EVR-Tuiasi/Shield_VCU_Board/Shield_VCU_Board/8.3D/PCB_proto_V1.0DWG.jpeg

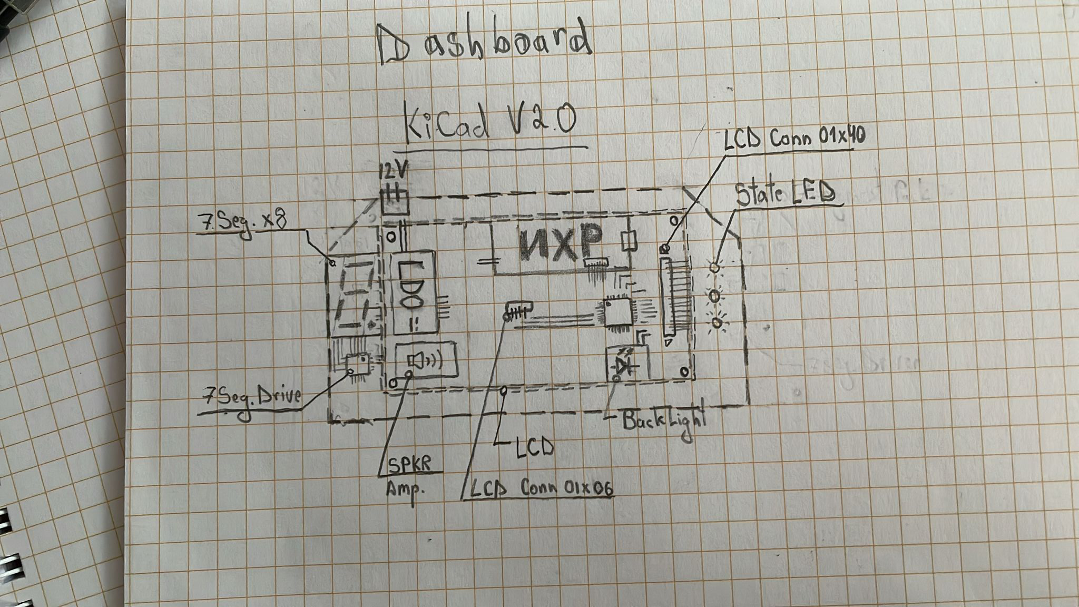
Shield_VCU_Board/8.3D/PCB_proto_V1.0DWG.jpeg
