EVR-Tuiasi/Shield_VCU_Board/Shield_VCU_Board/3.Simulations/8x7SEG_FULL_ON_simulation.jpg

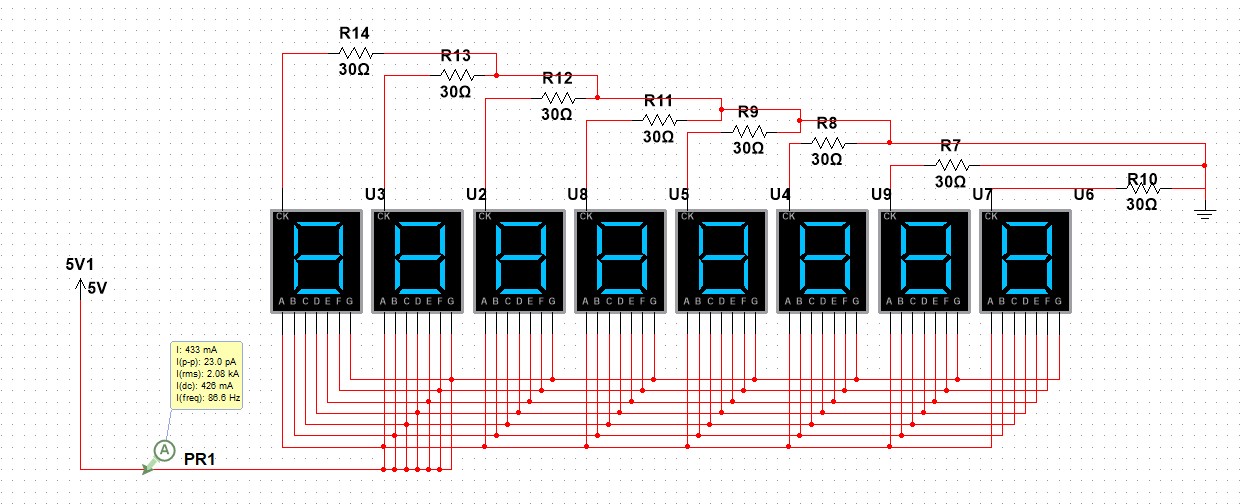
Shield_VCU_Board/3.Simulations/8x7SEG_FULL_ON_simulation.jpg
