EVR-Tuiasi/Shield_VCU_Board/Shield_VCU_Board/3.Simulations/Power_ON3V3_simulation.jpg

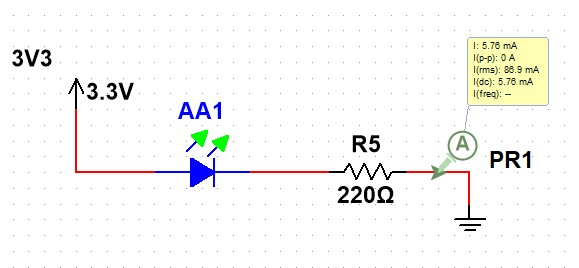
Shield_VCU_Board/3.Simulations/Power_ON3V3_simulation.jpg
