EVR-Tuiasi/Shield_VCU_Board/Shield_VCU_Board/3.Simulations/State_LED_12V_simulation.jpg

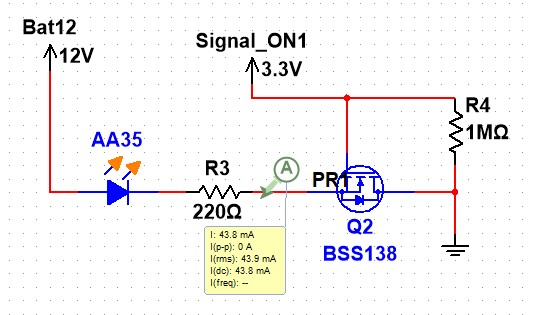
Shield_VCU_Board/3.Simulations/State_LED_12V_simulation.jpg
