EVR-Tuiasi/Shield_VCU_Board/Shield_VCU_Board/4.SupplyArchitecture/BoardSupply.png

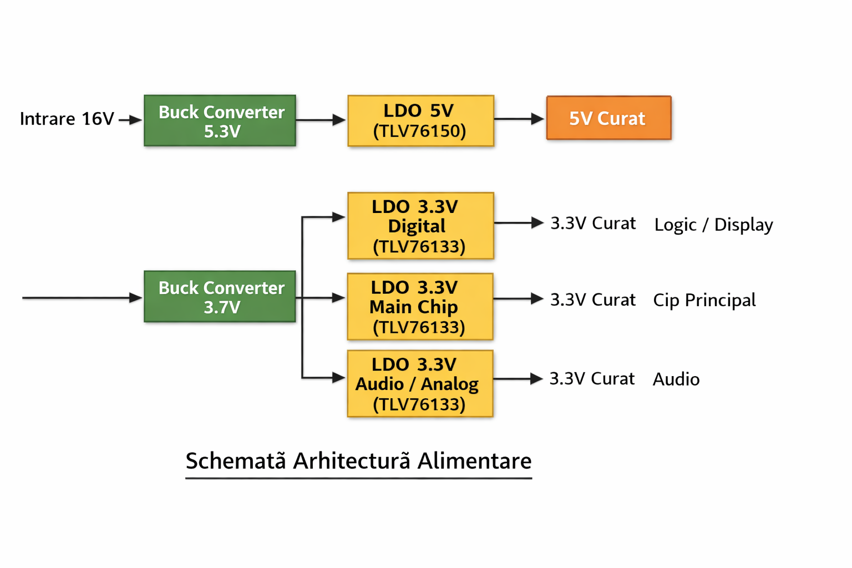
Shield_VCU_Board/4.SupplyArchitecture/BoardSupply.png
