EVR-Tuiasi/Shield_VCU_Board/Shield_VCU_Board/2.DataSheets/S32K344MINI-EVB_HWPackage/Rev. B1/S32K344MINI_RevB1_BOM.xlsx

S32K344MINI-EVB Revised: Wednesday, November 05, 2025
SCH-94921 PDF: SPF-94921 Revision: B1
NXP Semiconductors
6501 William Cannon Drive West
Austin, TX 78735-8598
Bill Of Materials November 19,2025 16:47:33 | Page1
Item | Quantity | AgilePN | ASSY_OPT | Reference | Value | Description | ASSY_NOTE | Mfg Name | Mfg Part Number | PCB Footprint
______________________________________________
1 | 7 | 150-80276 | DNP | C1,C9,C63,C134,C135,C137, | 0.22UF | CAP CER 0.22uF 35V 10% X7R AEC-Q200 0402 |  | TDK | CGA2B1X7R1V224K050BC | CC0402_25
 |  |  |  | C138
2 | 6 | 150-79004 |  | C2,C4,C5,C7,C22,C106 | 10uF | CAP CER 10uF 25V 10% X7R AEC-Q200 1210 |  | MURATA | GCM32ER71E106KA57 | CC1210
3 | 61 | 150-80276 |  | C3,C8,C11,C13,C16,C18, | 0.22UF | CAP CER 0.22uF 35V 10% X7R AEC-Q200 0402 |  | TDK | CGA2B1X7R1V224K050BC | CC0402_25
 |  |  |  | C21,C26,C27,C28,C34,C36,
 |  |  |  | C38,C39,C40,C42,C44,C45,
 |  |  |  | C46,C47,C48,C55,C56,C57,
 |  |  |  | C81,C82,C83,C84,C85,C86,
 |  |  |  | C89,C90,C91,C92,C96,C97,
 |  |  |  | C98,C100,C101,C103,C107,
 |  |  |  | C109,C111,C115,C132,C141,
 |  |  |  | C142,C143,C144,C145,C146,
 |  |  |  | C147,C149,C150,C151,C152,
 |  |  |  | C153,C154,C155,C157,C158
4 | 1 | 150-81432 |  | C6 | 47uF | CAP ALEL 47uF 50V 20% -- SMT |  | Wurth Electronics Inc. | 865080645012 | cce6p8x6p8x8mm
5 | 11 | 150-79081 |  | C10,C12,C14,C20,C29,C32, | 1UF | CAP CER 1uF 25V 10% X7R AEC-Q200 0603 |  | TDK | CGA3E1X7R1E105K080AC | CC0603_OV
 |  |  |  | C41,C102,C108,C140,C159
6 | 4 | 150-10268 |  | C15,C17,C24,C25 | 22uF | CAP CER 22uF 16V 20% X7S AEC-Q200 1206 |  | MURATA | GCM31CC71C226ME36K | cc1206_tol0p3
7 | 2 | 150-79727 |  | C19,C23 | 0.047uF | CAP CER 0.047uF 16V 10% X7R AEC-Q200 0402 |  | MURATA | GCM155R71C473KA37D | CC0402_25
8 | 6 | 150-80122 |  | C30,C31,C37,C49,C75,C79 | 2.2uF | CAP CER 2.2uF 16V 10% X7R 0603 |  | MURATA | GRM188Z71C225KE43 | CC0603_OV
9 | 9 | 150-80120 |  | C33,C35,C43,C54,C87,C88, | 10uF | CAP CER 10uF 10V 20% X7R 0603 |  | MURATA | GRM188Z71A106MA73 | CC0603
 |  |  |  | C95,C110,C131
10 | 16 | 150-79461 |  | C50,C51,C52,C53,C58,C59, | 0.1uF | CAP CER 0.1uF 50V 10% X7R AEC-Q200 0402 |  | MURATA | GCM155R71H104KE02D | CC0402_25
 |  |  |  | C60,C61,C70,C71,C77,C78,
 |  |  |  | C80,C121,C156,C163
11 | 1 | 150-79081 | DNP | C62 | 1UF | CAP CER 1uF 25V 10% X7R AEC-Q200 0603 |  | TDK | CGA3E1X7R1E105K080AC | CC0603_OV
12 | 1 | 150-80122 | DNP | C64 | 2.2uF | CAP CER 2.2uF 16V 10% X7R 0603 |  | MURATA | GRM188Z71C225KE43 | CC0603_OV
13 | 4 | 150-79023 |  | C65,C66,C93,C94 | 10pF | CAP CER 10pF 50V 5% C0G AEC-Q200 0402 |  | MURATA | GCM1555C1H100JA16 | CC0402_25
14 | 2 | 150-76570 |  | C67,C68 | 4.7uF | CAP CER 4.7UF 50V 10% X7R 1210 |  | YAGEO AMERICA | CC1210KKX7R9BB475 | CC1210
15 | 1 | 150-81038 |  | C69 | 47uF | CAP CER 47uF 16V 10% X6S 1210 |  | MURATA | GRM32EC81C476KE15L | CC1210
16 | 1 | 150-30114 |  | C72 | 0.01UF | CAP CER 0.01UF 50V 10% X7R 0402 |  | MURATA | GRM155R71H103KA88D | CC0402_25
17 | 2 | 150-79040 |  | C73,C148 | 1000pF | CAP CER 1000pF 50V 10% X7R AEC-Q200 0402 |  | MURATA | GCM155R71H102KA37D | CC0402_25
18 | 2 | 150-80123 |  | C74,C76 | 4.7uF | CAP CER 4.7uF 16V 10% X7R 0603 |  | MURATA | GRM188Z71C475KE21 | CC0603_OV
19 | 1 | 150-79461 | DNP | C99 | 0.1uF | CAP CER 0.1uF 50V 10% X7R AEC-Q200 0402 |  | MURATA | GCM155R71H104KE02D | CC0402_25
20 | 4 | 150-79021 | DNP | C104,C105,C113,C114 | 100pF | CAP CER 100pF 50V 5% C0G AEC-Q200 0402 |  | MURATA | GCM1555C1H101JA16D | CC0402_25
21 | 1 | 150-30045 |  | C112 | 4700 PF | CAP CER 4700PF 50V 5% X7R 0603 |  | AVX | 06035C472JAT2A | CC0603_OV
22 | 2 | 150-79103 |  | C116,C128 | 1000pF | CAP CER 1000pF 2KV 10% X7R 1206 |  | WALSIN TECHNOLOGY CORP. | 1206B102K202CT | CC1206_OV
23 | 4 | 150-81667 | DNP | C117,C118,C119,C120 | 15pF | CAP CER 15pF 50V 5% C0G 0402 |  | Murata Electronics | GJM1555C1H150JB01D | CC0402_25
24 | 4 | 150-10038 |  | C122,C124,C126,C160 | 0.1uF | CAP CER 0.1uF 100V X7R 10% AEC-Q200 0603 |  | KYOCERA | KAM15BR72A104KT | CC0603_OV
25 | 1 | 150-79364 |  | C123 | 2.2uF | CAP CER 2.2uF 16V 10% X7R AEC-Q200 0805 |  | TDK | CGA4J3X7R1C225K125AB | CC0805_OV
26 | 2 | 150-79530 |  | C125,C127 | 22uF | CAP CER 22uF 10V 20% X5R 0603 |  | SAMSUNG | CL10A226MP7LUNC | CC0603_OV
27 | 2 | 150-79024 |  | C129,C130 | 22pF | CAP CER 22pF 50V 5% C0G AEC-Q200 0402 |  | FENGHUA | AM02CG220J500NT | CC0402_25
28 | 1 | 150-80120 | DNP | C133 | 10uF | CAP CER 10uF 10V 20% X7R 0603 |  | MURATA | GRM188Z71A106MA73 | CC0603
29 | 1 | 150-79004 | DNP | C136 | 10uF | CAP CER 10uF 25V 10% X7R AEC-Q200 1210 |  | MURATA | GCM32ER71E106KA57 | CC1210
30 | 2 | 150-80098 |  | C161,C162 | 100uF | CAP ALEL 100uF 50V 20% -- AEC-Q200 SMT |  | PANASONIC | EEE-FTH101XAP | cce6p8x6p8
31 | 1 | 480-78943 | DNP | D1 | PMEG4050EP | DIODE SCH RECT 5A 40V AEC-Q101 SOD128 |  | NEXPERIA | PMEG4050EP,115 | SOD-128
32 | 4 | 480-78943 |  | D2,D11,D12,D13 | PMEG4050EP | DIODE SCH RECT 5A 40V AEC-Q101 SOD128 |  | NEXPERIA | PMEG4050EP,115 | SOD-128
33 | 5 | 370-76775 |  | D3,D4,D5,D6,D18 | BLUE LED | LED BLUE CLEAR SGL 20MA 3.2V 0603 SMT |  | WURTH ELEKTRONIK EISOS GMBH & CO. KG (ELECTRONIC & ELECTROMEHANICAL COMP) | 150060BS75000 | LED_0603
34 | 1 | 480-79952 |  | D7 | BZX84-A7V5 | DIODE ZENER 7.5V 250MW AEC-Q101 SOT23 |  | NEXPERIA | BZX84-A7V5 | sot23_a
35 | 1 | 480-30039 |  | D8 | BAT54HT1 | DIODE SCH 30V 200MA -- SOD323 |  | ON SEMICONDUCTOR | BAT54HT1G | SOD323
36 | 1 | 370-10031 |  | D9 | LED ORANGE | LED OR SGL 2.0V 20mA 0603 |  | OSRAM | KO EELP41.22-Q1S2-25-A8J8-020-R18 | led_0603_h020
37 | 2 | 370-76779 |  | D10,D17 | LED RED | LED BRIGHT RED CLEAR SGL 2V 20MA SMT 0603 |  | WURTH ELEKTRONIK EISOS GMBH & CO. KG (ELECTRONIC & ELECTROMEHANICAL COMP) | 150060RS75000 | LED_0603
38 | 2 | 480-80372 |  | D14,D15 | PESD1IVN27-AX | DIODE ESD PROTECTION 3A 27V AEC-Q101 SOD323 |  | Nexperia | PESD1IVN27-AX | sod323_bid
39 | 1 | 370-76899 |  | D16 | RGB | LED RED/GRN/BL TRI 20/20/20MA SMT |  | Lianyungang Meihua Electronics Technology Co.,Ltd | MHPA2525RGBDT-S | led4_2p7x2p6_sm
40 | 1 | 480-79703 |  | D20 | PMEG6045ETP | DIODE SCHOTTKY 60V 4.5A AEC-Q101 SOD128 |  | NEXPERIA | PMEG6045ETPX | sod-128
41 | 1 | 510-10068 |  | F1 | MFU0603FF04000P500 | FUSE BOARD MOUNT 4A 32VDC 0603 |  | VISHAY INTERTECHNOLOGY | MFU0603FF04000P500 | fuse_1p6x0p8_22h
42 | 1 | 510-10080 |  | F2 | MFU1206FF06300P500 | FUSE FAST 6.3A 63V SMT 1206 |  | Vishay | MFU1206FF06300P500 | fuse_3p2x1p6
43 | 3 | 210-81775 |  | JA1,JA3,J4 | CON 2x8 | CON 2X8 SKT SHRD TH 100MIL CTR 345H AU 126L |  | ANYTRONIC CORPORATION LIMITED | 08010S31611-29RF | con_2x8_skt_100_th
44 | 3 | 210-81776 |  | J2,J5,JA6 | CON 2x10 | CON 2X10 SKT SHRD TH 100MIL CTR 345H AU 126L |  | ANYTRONIC CORPORATION LIMITED | 08010S32011-29RF | con_skt2x10_th
45 | 2 | 210-82022 | DNP | JB1,JB3 | CON_1X8 | CON 1X8 SKT TH 100MIL SP 340H AU 122L |  | WURTH ELEKTRONIK EISOS GMBH & CO. KG (ELECTRONIC & ELECTROMEHANICAL COMP) | 61300811821 | con_skt1x8_th_380h
46 | 1 | 210-82028 | DNP | JB6 | CON_1X10 | CON 1X10 SKT TH 100MIL SP 340H AU 122L |  | WURTH ELEKTRONIK EISOS GMBH & CO. KG (ELECTRONIC & ELECTROMEHANICAL COMP) | 61301011821 | con1x10_2p54mm_th
47 | 1 | 210-80732 |  | JP1 | HDR 1X3 | HDR 1X3 TH 2.54MM SP 344H AU 118L |  | CNT Electrical Company Ltd | CNT-M254-1*3-GS-6/3-01 | HDR103_A
48 | 3 | 210-80468 |  | JP4,JP5,JP11 | HDR1X2 | HDR 1X2 TH 100MIL SP 342H AU 118L |  | WURTH ELEKTRONIK EISOS GMBH & CO. KG (ELECTRONIC & ELECTROMEHANICAL COMP) | 61300211121 | hdr1x2_5p48x2p69
49 | 1 | 210-83436 |  | J7 | RJ45X2_LEDYG | CON 8 RJ-45 SHLD RA TH YG LEDS 40MIL SP 47H AU 79L |  | Donguan Heling Electronic Co., LTD | MJ88B-B011-RVL11-P | con12p_1p02_16p48x15p5_ra_th
50 | 1 | 211-75161 | DNP | J8 | CON 2X30 SKT | CON 2X30 SKT SMT 0.5MM SP 120H AU MOUNTING HOLES TO MATE CABLE HQCD-030-15.00-TBL-TBR-1-SDB |  | SAMTEC | QSH-030-01-L-D-A_ | CON_60S_QSH_SM_A
51 | 1 | 211-10319 |  | J9 | HDR 2X10 SMT | HDR 2X10 SMT 50MIL SP 205H AU |  | Boom Precision Electronics Co., Ltd. Zhejiang | 1.27-LT-2X10T | hdr_2x10_13p0x3p5_smt
52 | 1 | 210-79945 | DNP | J10 | CON PWR 3 | CON 3 PWR JACK RA TH 295H -- NI 98L |  | CUI INC | PJ-051A | con3_pwr_jack_th_pj051a
53 | 1 | 211-10321 |  | J11 | USB_TYPE_C | CON 24 USB TYPE C RA SHLD TH 0.5MM SP 132H -- |  | HAODE | TYPE-C 24PIN4DSMT | con_type-c_20mil_ra_ldi
54 | 1 | 210-80468 | DNP | J12 | HDR1X2 | HDR 1X2 TH 100MIL SP 342H AU 118L |  | WURTH ELEKTRONIK EISOS GMBH & CO. KG (ELECTRONIC & ELECTROMEHANICAL COMP) | 61300211121 | hdr1x2_5p48x2p69
55 | 1 | 210-81466 |  | J13 | HDR 2X5 | HDR 2X5 TH 50MIL CTR 172H AU 91L |  | CNT Electrical Company Ltd | CNT-M127-2*5-GS-3/2.3-100 | hdr205_50_th_172h
56 | 2 | 210-82024 |  | J14,J15 | CON_1X4 | CON 1X4 SKT TH 100MIL SP 340H AU 122L |  | WURTH ELEKTRONIK EISOS GMBH & CO. KG (ELECTRONIC & ELECTROMEHANICAL COMP) | 61300411821 | con_skt1x4_th_346h
57 | 1 | 180-78917 |  | L1 | 4.7uH | IND PWR 4.7uH@100kHz 10.9A 20% AEC-Q200 SMT |  | TDK | SPM6545VT- 4R7M-D | ind2_7p4x6p9_sm
58 | 1 | 180-79023 |  | L2 | 8.2uH | IND PWR 8.2uH@1MHZ 2.4A 20% AEC-Q200 SMT |  | COILCRAFT | XAL4040-822ME | ind2_xal40
59 | 1 | 180-78522 |  | L3 | 1.0uH | IND PWR 1uH@1MHZ 3.3A 20% AEC-Q200 2016 |  | TDK | TFM201610ALMA1R0MTAA | ind_2016a
60 | 1 | 180-78959 |  | L4 | 300Ohms@100MHz | IND FER BEAD 300Ohms@100MHz 2A 25% 0603 |  | WURTH ELEKTRONIK EISOS GMBH & CO. KG (ELECTRONIC & ELECTROMEHANICAL COMP) | 742792641 | ind_1p8x1mm_sm
61 | 1 | 180-77768 |  | L5 | 30 OHM | IND FER BEAD 30 OHM@100MHZ 2.2A 25% 0402 |  | MURATA | BLM15PD300SN1D | IND_0402
62 | 2 | 180-78352 |  | L6,L7 | BLM18KG121TZ1 | IND FER BEAD 120OHM@100MHZ 3A 25% AEC-Q200 0603 |  | MURATA | BLM18KG121TZ1 | IND_0603
63 | 1 | 180-10084 |  | L8 | 470 Ohm | IND FER BEAD 470OHM@100MHz 500mA 25% AEC-Q200 0603 |  | MURATA | BLM18EG471SZ1D | IND_0603
64 | 1 | 180-79730 |  | L9 | 120 OHM@100MHz | IND BEAD FER 120 OHM@100MHz 600mA 25% AEC-Q200 0603 |  | TDK Corporation | MMZ1608B121CTDH5 | IND_0603
65 | 1 | 480-80563 |  | Q1 | BUK9D23-40EX | TRAN NMOS PWR 8A 40V AEC-Q101 SOT-1220 |  | NEXPERIA | BUK9D23-40EX | sot1220
66 | 2 | 480-79881 |  | Q2,Q13 | BC846B | TRAN NPN GEN 65V 0.1A SOT23 |  | NEXPERIA | BC846B,215 | SOT23_A
67 | 1 | 480-75778 |  | Q3 | BSH103 | TRAN NMOS SW 30VDS SOT-23 |  | PHILIPS SEMICONDUCTOR | BSH103 | sot23
68 | 1 | 480-79956 | DNP | Q5 | BCP56-16TX | TRANS NPN 80V 1A AEC-Q101 SOT223 |  | NEXPERIA | BCP56-16TX | SOT223
69 | 2 | 480-79950 |  | Q6,Q11 | BC857B | TRAN PNP GEN 100MA 45V AEC-Q101 SOT23 |  | NEXPERIA | BC857B,235 | sot23_a
70 | 2 | 480-80155 |  | Q7,Q12 | BC847B | TRAN NPN GEN SW 45V 0.1A SOT23 |  | NEXPERIA | BC847B | SOT23_A
71 | 3 | 480-80562 |  | Q8,Q9,Q10 | 2SC4738-GR,LF | TRAN NPN AMP 150mA 50V AEC-Q101 SC75 |  | TOSHIBA | 2SC4738-GR,LF | sc_75
72 | 4 | 470-81628 |  | R1,R16,R19,R26 | 5.1K | RES MF 5.1K 1/10W 1% AEC-Q200 0402 |  | KOA SPEER | RK73H1ETTP5101F | RC0402_25
73 | 83 | 470-80742 | DNP | R4,R50,R64,R65,R66,R67, | 0 | RES MF ZERO OHM 1/16W -- AEC-Q200 0402 |  | VISHAY INTERTECHNOLOGY | CRCW04020000Z0ED | RC0402_25
 |  |  |  | R76,R79,R81,R107,R116,
 |  |  |  | R118,R194,R199,R200,R202,
 |  |  |  | R212,R213,R214,R215,R230,
 |  |  |  | R231,R245,R246,R247,R248,
 |  |  |  | R250,R251,R266,R269,R272,
 |  |  |  | R273,R274,R276,R278,R279,
 |  |  |  | R282,R283,R288,R292,R293,
 |  |  |  | R301,R302,R303,R304,R305,
 |  |  |  | R311,R350,R351,R352,R353,
 |  |  |  | R371,R372,R373,R384,R385,
 |  |  |  | R386,R387,R388,R390,R393,
 |  |  |  | R395,R398,R399,R400,R402,
 |  |  |  | R410,R413,R414,R416,R418,
 |  |  |  | R420,R421,R422,R423,R430,
 |  |  |  | R433,R434,R435,R443,R448,
 |  |  |  | R449,R454
74 | 6 | 470-75840 |  | R5,R9,R10,R321,R322,R440 | 680 | RES MF 680 OHM 1/10W 5% 0603 |  | BOURNS | CR0603-JW-681ELF | RC0603_OV
75 | 154 | 470-80742 |  | R6,R17,R22,R34,R35,R37, | 0 | RES MF ZERO OHM 1/16W -- AEC-Q200 0402 |  | VISHAY INTERTECHNOLOGY | CRCW04020000Z0ED | RC0402_25
 |  |  |  | R38,R39,R46,R48,R51,R52,
 |  |  |  | R53,R54,R55,R56,R57,R58,
 |  |  |  | R59,R60,R61,R62,R63,R68,
 |  |  |  | R69,R70,R71,R72,R73,R74,
 |  |  |  | R75,R77,R78,R80,R84,R85,
 |  |  |  | R89,R90,R91,R93,R94,R95,
 |  |  |  | R96,R98,R99,R100,R101,
 |  |  |  | R102,R105,R106,R108,R109,
 |  |  |  | R113,R114,R119,R120,R121,
 |  |  |  | R124,R125,R126,R127,R135,
 |  |  |  | R139,R140,R147,R148,R155,
 |  |  |  | R166,R174,R175,R177,R187,
 |  |  |  | R189,R190,R210,R211,R224,
 |  |  |  | R227,R233,R241,R242,R249,
 |  |  |  | R257,R258,R259,R260,R261,
 |  |  |  | R262,R263,R265,R267,R280,
 |  |  |  | R281,R313,R315,R317,R318,
 |  |  |  | R323,R324,R331,R332,R334,
 |  |  |  | R336,R337,R339,R363,R375,
 |  |  |  | R376,R377,R378,R379,R380,
 |  |  |  | R381,R382,R383,R389,R391,
 |  |  |  | R392,R394,R401,R403,R404,
 |  |  |  | R405,R406,R407,R408,R409,
 |  |  |  | R411,R412,R415,R417,R419,
 |  |  |  | R424,R425,R426,R427,R428,
 |  |  |  | R429,R431,R432,R436,R437,
 |  |  |  | R438,R439,R452,R453,R516,
 |  |  |  | R517,R518,R519,R520,R525,
 |  |  |  | R526,R527
76 | 5 | 470-30048 |  | R8,R162,R163,R164,R165 | 2.0K | RES MF 2.0K 1/4W 1% 1206 |  | VISHAY INTERTECHNOLOGY | CRCW12062K00FKEA | RC1206_OV
77 | 2 | 470-79380 |  | R11,R12 | 0.1 | RES MF 0.10 OHM 1/2W 1% 1206 |  | PANASONIC | ERJ-8BWFR100V | rc1206_erj-8bw
78 | 56 | 470-10285 |  | R14,R23,R24,R27,R28,R33, | 10K | RES MF 10K 1/16W 1% 0402 |  | Royalohm | 0402WGF1002TCE | RC0402_25
 |  |  |  | R40,R87,R92,R97,R112,
 |  |  |  | R130,R131,R133,R143,R149,
 |  |  |  | R151,R152,R154,R156,R157,
 |  |  |  | R158,R159,R160,R161,R171,
 |  |  |  | R172,R173,R179,R264,R306,
 |  |  |  | R333,R338,R341,R343,R344,
 |  |  |  | R345,R347,R348,R349,R354,
 |  |  |  | R355,R356,R357,R358,R359,
 |  |  |  | R360,R366,R396,R397,R441,
 |  |  |  | R521,R522,R524,R541,R543
79 | 1 | 470-30771 |  | R15 | 215 | RES MF 215 OHM 1/10W 1% AEC-Q200 0402 |  | KOA SPEER | RK73H1ETTP2150F | RC0402_25
80 | 6 | 470-81714 |  | R18,R44,R335,R340,R342, | 33K | RES MF 33K 1/10W 1% AEC-Q200 0402 |  | KOA SPEER | RK73H1ETTP3302F | RC0402_25
 |  |  |  | R442
81 | 11 | 470-75407 |  | R20,R43,R197,R256,R528, | 0 | RES MF ZERO OHM 1/10W -- AEC-Q200 0603 |  | PANASONIC | ERJ-3GEY0R00V | RC0603_OV
 |  |  |  | R530,R531,R532,R533,R534,
 |  |  |  | R732
82 | 1 | 470-75607 |  | R21 | 220 | RES MF 220 OHM 1/16W 5% 0402 |  | NIC COMPONENTS CORP | NRCL04J221TRF | RC0402_25
83 | 1 | 470-30983 |  | R29 | 22K | RES MF 22K 1/10W 1% AEC-Q200 0402 |  | KOA SPEER | RK73H1ETTP2202F | RC0402_25
84 | 1 | 470-78065 |  | R31 | 30.9K | RES MF 30.9K 1/10W 1% AEC-Q200 0603 |  | KOA SPEER | RK73H1JTTD3092F | RC0603_OV
85 | 1 | 470-81688 |  | R32 | 300 | RES MF 300 OHM 1/8W 1% AEC-Q200 0603 |  | KOA SPEER | RK73H1JTTD3000F | RC0603_OV
86 | 5 | 470-75407 | DNP | R42,R523,R529,R535,R536 | 0 | RES MF ZERO OHM 1/10W -- AEC-Q200 0603 |  | PANASONIC | ERJ-3GEY0R00V | RC0603_OV
87 | 1 | 470-80807 | DNP | R47 | 2.2K | RES MF 2.2K 1/10W 5% AEC-Q200 0603 |  | PANASONIC | ERJ3GEYJ222V | RC0603_OV
88 | 2 | 470-81272 |  | R82,R83 | 0 | RES MF ZERO OHM JUMPER 1/2W AEC-Q200 0805 |  | VISHAY INTERTECHNOLOGY | CRCW08050000Z0EAHP | RC0805_OV
89 | 4 | 470-80502 |  | R86,R111,R144,R367 | 100k | RES MF 100k Ohm 1/16W 1% AEC-Q200 0402 |  | KOA SPEER | RK73H1ETTP1003F | RC0402_25
90 | 5 | 470-80502 | DNP | R88,R455,R456,R457,R458 | 100k | RES MF 100k Ohm 1/16W 1% AEC-Q200 0402 |  | KOA SPEER | RK73H1ETTP1003F | RC0402_25
91 | 1 | 470-80822 |  | R104 | 1M | RES 1.0M OHM 1/3W 1% AEC-Q200 0603 |  | VISHAY INTERTECHNOLOGY | CRCW06031M00FKEAHP | RC0603_OV
92 | 5 | 470-81976 |  | R110,R132,R141,R319,R362 | 4.7K | RES MF 4.7K 1/10W 1% AEC-Q200 0402 |  | KOA SPEER | RK73H1ETTP4701F | RC0402_25
93 | 26 | 470-10285 | DNP | R115,R117,R138,R150,R153, | 10K | RES MF 10K 1/16W 1% 0402 |  | Royalohm | 0402WGF1002TCE | RC0402_25
 |  |  |  | R167,R168,R170,R180,R181,
 |  |  |  | R182,R268,R275,R277,R287,
 |  |  |  | R289,R290,R291,R295,R296,
 |  |  |  | R307,R308,R309,R346,R537,
 |  |  |  | R539
94 | 2 | 470-81628 | DNP | R123,R128 | 5.1K | RES MF 5.1K 1/10W 1% AEC-Q200 0402 |  | KOA SPEER | RK73H1ETTP5101F | RC0402_25
95 | 1 | 470-76198 |  | R129 | 330 | RES MF 330 OHM 1/10W 1% 0603 |  | WALSIN TECHNOLOGY CORP. | WR06X3300FTL | RC0603_OV
96 | 2 | 470-31088 |  | R134,R145 | 180K | RES MF 180K 1/10W 1% AEC-Q200 0402 |  | KOA SPEER | RK73H1ETTP1803F | RC0402_25
97 | 1 | 470-30919 |  | R136 | 5.6K | RES MF 5.6K 1/16W 1% 0402 |  | YAGEO AMERICA | RC0402FR-075K6L | RC0402_25
98 | 3 | 470-81184 |  | R137,R320,R361 | 560 OHM | RES TF 560 OHM 1/4W 1% AEC-Q200 0603 |  | VISHAY INTERTECHNOLOGY | CRCW0603560RFKEAHP | RC0603_OV
99 | 2 | 470-81693 |  | R142,R365 | 18K | RES MF 18K 1/10W 1% AEC-Q200 0402 |  | KOA SPEER | RK73H1ETTP1802F | RC0402_25
100 | 6 | 470-76037 |  | R169,R216,R217,R369,R538, | 1.0K | RES MF 1.0K 1/16W 1% 0402 |  | YAGEO AMERICA | RC0402FR-071KL | RC0402_25
 |  |  |  | R540
101 | 2 | 470-78243 |  | R176,R178 | 60.4 | RES MF 60.4 OHM 1/4W 1% 1206 |  | VISHAY INTERTECHNOLOGY | CRCW120660R4FKEA | RC1206_OV
102 | 29 | 470-82133 | DNP | R183,R184,R185,R186,R206, | 51K | RES TF 51K OHM 1/20W 1% 0201 |  | YAGEO AMERICA | RC0201FR-0751KL | RC0201
 |  |  |  | R207,R208,R209,R221,R222,
 |  |  |  | R225,R236,R237,R238,R239,
 |  |  |  | R252,R253,R254,R255,R297,
 |  |  |  | R298,R299,R300,R325,R326,
 |  |  |  | R327,R328,R329,R330
103 | 6 | 470-75360 |  | R188,R193,R198,R201,R203, | 49.9 | RES MF 49.9 OHM 1/16W 1% 0402 |  | BOURNS | CR0402-FX-49R9GLF | RC0402_25
 |  |  |  | R204
104 | 4 | 470-75360 | DNP | R191,R192,R195,R196 | 49.9 | RES MF 49.9 OHM 1/16W 1% 0402 |  | BOURNS | CR0402-FX-49R9GLF | RC0402_25
105 | 2 | 470-30729 |  | R205,R218 | 75 | RES MF 75.0 OHM 1/10W 1% AEC-Q200 0402 |  | KOA SPEER | RK73H1ETTP75R0F | RC0402_25
106 | 2 | 470-30315 |  | R219,R226 | 470 | RES MF 470 OHM 1/16W 5% 0402 |  | PANASONIC | ERJ2GEJ471X | RC0402_25
107 | 10 | 470-80961 |  | R220,R223,R228,R229,R232, | 33 OHM | RES MF 33 OHM 1/10W 1% AEC-Q200 0402 |  | PANASONIC | ERJ2RKF33R0X | RC0402_25
 |  |  |  | R234,R243,R244,R270,R271
108 | 1 | 470-75494 |  | R235 | 1.0M | RES MF 1.0M 1/8W 5% 0805 |  | BOURNS | CR0805-JW-105ELF | RC0805_OV
109 | 1 | 470-81665 |  | R240 | 6.49K | RES MF 6.49K 1/10W 1% AEC-Q200 0402 |  | KOA SPEER | RK73H1ETTP6491F | RC0402_25
110 | 3 | 470-80961 | DNP | R284,R285,R286 | 33 OHM | RES MF 33 OHM 1/10W 1% AEC-Q200 0402 |  | PANASONIC | ERJ2RKF33R0X | RC0402_25
111 | 1 | 470-80978 |  | R364 | 10 | RES MF 10 OHM 1/16W 1% AEC-Q200 0402 |  | KOA SPEER | RK73H1ETTP10R0F | RC0402_25
112 | 1 | 470-31088 | DNP | R368 | 180K | RES MF 180K 1/10W 1% AEC-Q200 0402 |  | KOA SPEER | RK73H1ETTP1803F | RC0402_25
113 | 1 | 470-10272 |  | R370 | 10K | RES POT 10K 1/2W 10% TH |  | Bourns | 3362W-1-103LF | pot3_3362w
114 | 3 | 470-75924 |  | R500,R501,R731 | 0 | RES MF ZERO OHM 1/4W AEC-Q200 1206 |  | KOA SPEER | RK73Z2BTTD | RC1206_OV
115 | 1 | 470-75924 | DNP | R502 | 0 | RES MF ZERO OHM 1/4W AEC-Q200 1206 |  | KOA SPEER | RK73Z2BTTD | RC1206_OV
116 | 2 | 470-76037 | DNP | R542,R544 | 1.0K | RES MF 1.0K 1/16W 1% 0402 |  | YAGEO AMERICA | RC0402FR-071KL | RC0402_25
117 | 1 | 470-75849 | DNP | R730 | 47K | RES MF 47K 1/10W 5% 0603 |  | BOURNS | CR0603-JW-473ELF | RC0603_OV
118 | 3 | 470-83437 |  | SJ1,SJ4,SJ5 | 3 PIN 0603 SHORT 1-2 | SOLDER BLOB JUMPER 3PIN 1-2 SHORT SOLDER 0603 - NO PART TO ORDER |  |  |  | 3pin_0603_solder_blob_jumper_short
119 | 1 | 470-83592 |  | SJ2 | 3 PIN 0402 JUMPER | SOLDER BLOB JUMPER 3PIN 1-2 SHORT SOLDER 0402 - NO PART TO ORDER |  | NA | 3 PIN 0402 JUMPER | 3pin_0402x2_a
120 | 3 | 510-78653 |  | SW2,SW3,SW4 | SW SPST NO | SW SP PB 50mA 16V SMT |  | WURTH ELEKTRONIK EISOS GMBH & CO. KG (ELECTRONIC & ELECTROMEHANICAL COMP) | 434123025826 | sw4_4p15_4p2x3p2_sm
121 | 1 | 510-78053 |  | SW5 | M096H-A020RT21A | SW DPDT SLD 0.03A 50V TH |  | FODOT ELECTRONICS CO.,LTD. | M096H-A020RT21A | sw6_dpdt_m096h_th
122 | 11 | 210-81066 | DNP | TPH2,TPH3,TPH6,TPH7, | HDR 1X1 | HDR 1X1 TH -- 338H AU 100L |  | SAMTEC | TSW-101-07-F-S | HDR_1X1
 |  |  |  | TPH10,TPH11,TPH12,TPH16,
 |  |  |  | TPH19,TPH23,TPH24
123 | 47 | 211-76642 |  | TP8,TP9,TP15,TP16,TP17, | TPAD_030 | TEST POINT PAD 30MIL DIA SMT, NO PART TO ORDER |  | NOTACOMPONENT | NOTACOMPONENT | TPAD_030
 |  |  |  | TP18,TP19,TP20,TP29,TP44,
 |  |  |  | TP58,TP59,TP63,TP65,TP67,
 |  |  |  | TP68,TP69,TP70,TP71,TP72,
 |  |  |  | TP73,TP74,TP75,TP76,TP77,
 |  |  |  | TP78,TP79,TP89,TP90,
 |  |  |  | TP117,TP118,TP119,TP120,
 |  |  |  | TP121,TP122,TP123,TP124,
 |  |  |  | TP125,TP126,TP127,TP128,
 |  |  |  | TP129,TP130,TP131,TP132,
 |  |  |  | TP133,TP134
124 | 7 | 211-77484 |  | TP21,TP22,TP24,TP25,TP26, | TPAD_020 | TEST POINT PAD 0.5MM DIA SMT, NO PART TO ORDER |  |  |  | tpad_020
 |  |  |  | TP27,TP28
125 | 1 | 211-76644 |  | TP23 | TPAD_050 | TEST POINT PAD 50MIL DIA SMT, NO PART TO ORDER |  | NOTACOMPONENT | NOTACOMPONENT | TPAD_050
126 | 1 | 560-77654 |  | T1 | PT61018PEL | XFMR LAN 10/100BASE-TX 1CT:1CT SMT |  | BOURNS | PT61018PEL | xfmr16_1p27_13p05x7p15
127 | 1 | TMP-CIP-18872 |  | U1 | PFS2613AMDGVAD | IC SBC VREG 2LDO 2TRK ASIL VCORE 0.8V LQFP48 |  | NXP SEMICONDUCTOR | PFS2613AMDGVAD | LQFP48_EP146MIL
128 | 1 | 344-10064 |  | U2 | S32K344EHT1MPBST | IC MCU 4MB 160MHz 2.97-5.5V MAXQFP172 |  | NXP SEMICONDUCTOR | S32K344EHT1MPBST | mqfp172_0P65_16X16
129 | 1 | 315-81752 |  | U3 | NX20P3483UK | IC USB PD/TYPE-C PWR Sink/Source Combo SW 5A 2.8-20V WLCSP42 |  | NXP SEMICONDUCTORS | NX20P3483UK | wlcsp42_0p4_2p94x2p54_smdp
130 | 1 | 315-81118 |  | U4 | PTN5110 | IC USB PD PHY 1PORT 2.7-5.5V HX2QFN16 |  | NXP SEMICONDUCTOR | PTN5110NHQZ | hx2qfn16_0p4_2p7x2p7
131 | 1 | 315-83524 |  | U5 | TLV76033DBZR | IC LIN VREG 3.3V 100mA 30V SOT23 |  | Texas Instruments | TLV76033DBZR | SOT-23
132 | 1 | 315-84061 |  | U6 | PCMF1USB3S | IC EMI FILTER ESD PROTECTION 15kV/LINE WLCSP5 |  | NEXPERIA | PCMF1USB3SZ | wlcsp5_0p4_0p82x1p22
133 | 1 | 312-81846 |  | U7 | NX20P0407 | IC USB TYPE C PROTECTION +15KV/+8KV ESD WLCSP12 |  | NXP SEMICONDUCTORS | NX20P0407UKAZ | wlcsp12_0p4_1p3x1p7mm_smdp
134 | 1 | 344-02189 |  | U8 | MK26FN2M0VMI18 | IC MCU 2MB FLASH 256KB RAM ARM 180MHz 1.71-3.6V MAPBGA169 |  | NXP SEMICONDUCTOR | MK26FN2M0VMI18 | BGA169_0P65_9X9
135 | 1 | 312-83625 |  | U10 | NTS0102TLH | IC DUAL SUPPLY XCVR 50 MBPS 1.65-3.6V/2.3-5.5V XSON8 |  | NXP SEMICONDUCTORS | NTS0102TLH | xson8_0p5_3p1x2p1_ep
136 | 1 | 312-81345 |  | U11 | TJA1022T | IC XCVR DUAL LIN 5-18V AEC-Q100 SO14 |  | NXP SEMICONDUCTORS | TJA1022T,118 | soic14_1p27_4x8
137 | 1 | 312-83259 |  | U12 | TJA1043TK/1Y | IC XCVR DUAL HIGH SPEED CAN 4.5-5.5V AEC-Q100 HVSON14 |  | NXP SEMICONDUCTORS | TJA1043TK/1Y | hvson14_0p65_4p6x3p1_ep
138 | 1 | 480-80426 |  | U13 | PESD2CANFD24L-TR | DIODE 2CH ESD PROTECTOR 24V AEC-Q101 SOT23 |  | Nexperia | PESD2CANFD24L-TR | SOT23_A
139 | 1 | 312-10176 |  | U14 | KSZ8091RNDIA-TR | IC XCVR ETHERNET PHY 10/100Mbps RMII 3.3V QFN24 |  | MICROCHIP TECHNOLOGY INC | KSZ8091RNDIA-TR | qfn24_4x4mm_slug
140 | 1 | 312-81661 |  | U15 | NC7SZ08L6X | IC AND GATE 1.65-5.5V MICROPAK6 |  | FAIRCHILD | NC7SZ08L6X | micropack6_0p5_1x1p45
141 | 1 | 342-00710 |  | U16 | W25Q64JVSSIQ | IC MEM SERIAL FLASH DUAL/QUAD SPI 64MBIT 2.7-3.6V SOIC8 |  | WINBOND ELECTRONICS CORP | W25Q64JVSSIQ | so8_w
142 | 1 | 312-83121 |  | U17 | FXLS8964AF | IC ACCELEROMETER 3-AXIS 12BIT 1.71-3.6V AEC-Q100 DFN10 |  | NXP SEMICONDUCTORS | FXLS8964AFR3 | dfn10_0p4_2x2mm
143 | 1 | 312-10095 |  | U18 | P3T1750DP | IC DIG TEMP SENSOR I3C/I2C 1.4-3.6V TSSOP8 |  | NXP SEMICONDUCTOR | P3T1750DPZ | tssop8_a
144 | 2 | 230-10040 |  | Y1,Y2 | 16MHZ | XTAL 16MHZ 8pF AEC-Q200 SMT |  | NDK | STDCQS1-16M | xtlosc4_3p2x2p5mm_sm
145 | 1 | 230-78230 |  | Y3 | 25MHz | XTAL 25.000MHZ 30PPM 6PF AEC-Q200 SMT |  | MURATA | XRCGB25M000F3A00R0 | xtl4_2p1x1p7mm_sm
146 | 1 | 230-76894 |  | Y4 | 50MHZ | OSC 50MHZ FIXED 3.3V SMT |  | Diodes Incorporated | FN5000110 | XTLOSC4_SM
