EVR-Tuiasi/Shield_VCU_Board/Shield_VCU_Board/1.KiCad/Shield_VCU_Board.step

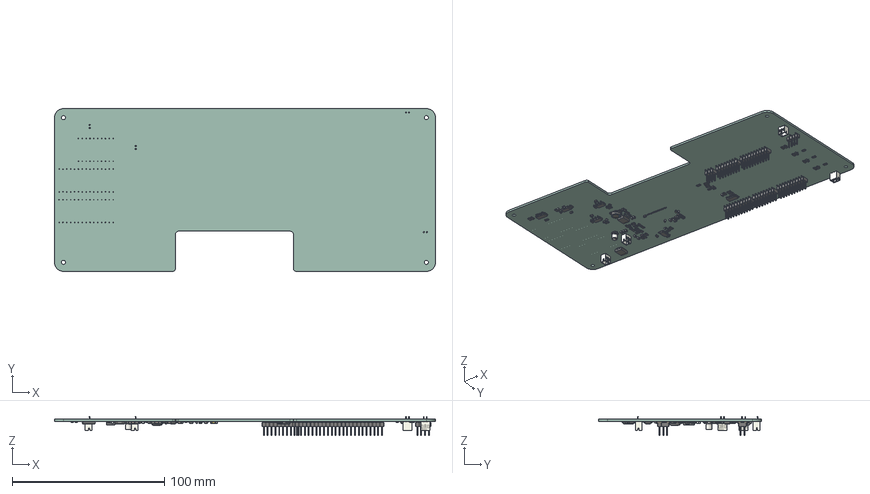
[picture p7: CAD file, 2026-04-24]
Shield_VCU_Board/1.KiCad/Shield_VCU_Board.step
250.5 x 107.1 x 12.7 mm
R_1206_3216Metric x 34
PinHeader_2x03_P2.54mm_Vertical_SMD
Oscillator_SMD_SeikoEpson_SG210-4Pin_2.5x2.0mm
C_0805_2012Metric x 36
SOT-23 x 4
D_SOD-123 x 4
LED_0805_2012Metric x 4
L_TDK_SLF7032
CP_Elec_4x5.4
D_SOD-523
D_SMC x 2
SOT-223 x 4
R_Array_Convex_4x0402 x 7
R_0201_0603Metric
PinHeader_1x04_P2.54mm_Vertical_SMD_Pin1Left
JST_PH_B2B-PH-K_1x02_P2.00mm_Vertical x 4
QSOP-24_3.9x8.7mm_P0.635mm
R_Cat16-4
PinHeader_2x10_P2.54mm_Vertical_SMD x 3
PinHeader_2x08_P2.54mm_Vertical_SMD x 2
SOT-23-5
CP_EIA-2012-12_Kemet-R
SOT-23-6
SOIC-14_3.9x8.7mm_P1.27mm
Shield_VCU_Board_PCB
