EVR-Tuiasi/Shield_VCU_Board/Shield_VCU_Board/2.DataSheets/S32K344MINI-EVB_HWPackage/Rev. C/NXP_Board_KiCad/NXP344_3dSample.step

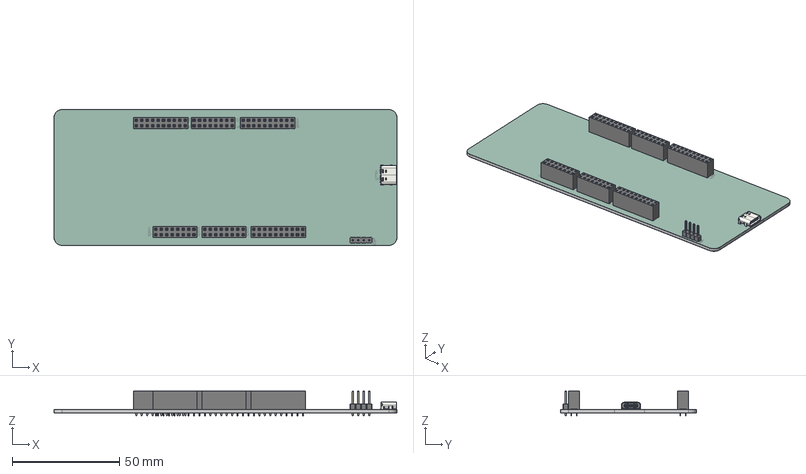
[picture p8: CAD file, 2026-04-24]
Shield_VCU_Board/2.DataSheets/S32K344MINI-EVB_HWPackage/Rev. C/NXP_Board_KiCad/NXP344_3dSample.step
160.0 x 63.4 x 11.6 mm
PinHeader_1x04_P2.54mm_Vertical
PinSocket_2x08_P2.54mm_Vertical x 3
PinSocket_2x10_P2.54mm_Vertical x 3
USB_C_Receptacle_GCT_USB4105-xx-A_16P_TopMnt_Horizontal
NXP_silkscreen
NXP_soldermask x 2
NXP_PCB
