EVR-Tuiasi/Shield_VCU_Board/Shield_VCU_Board/8.3D/Shield_VCU_Boardv2.0.step

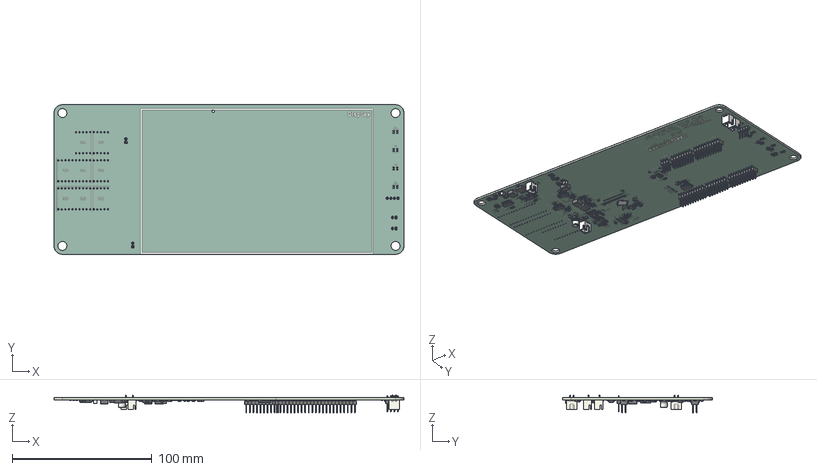
[picture p9: CAD file, 2026-06-24]
Shield_VCU_Board/8.3D/Shield_VCU_Boardv2.0.step
250.5 x 107.1 x 12.7 mm
SOT-23-6 x 3
R_1206_3216Metric x 38
PinHeader_2x03_P2.54mm_Vertical_SMD
Oscillator_SMD_SeikoEpson_SG210-4Pin_2.5x2.0mm
C_0805_2012Metric x 44
SOT-23 x 4
D_SOD-123 x 5
LED_0805_2012Metric x 4
L_Pulse_PA4340 x 3
CP_Elec_5x5.4
L_1206_3216Metric x 2
D_SMC x 2
SOT-223 x 4
R_Array_Convex_4x0402 x 7
R_0603_1608Metric
PinHeader_1x04_P2.54mm_Vertical
C_1210_3225Metric x 2
JST_XH_B2B-XH-A_1x02_P2.50mm_Vertical x 4
QSOP-24_3.9x8.7mm_P0.635mm
R_Cat16-4
PinHeader_2x10_P2.54mm_Vertical_SMD x 3
PinHeader_2x08_P2.54mm_Vertical_SMD x 2
SOT-23-5
CP_EIA-2012-12_Kemet-R
SOIC-14_3.9x8.7mm_P1.27mm
Shield_VCU_Board_copper
Shield_VCU_Board_pad
Shield_VCU_Board_via
Shield_VCU_Board_silkscreen x 2
Shield_VCU_Board_soldermask x 2
Shield_VCU_Board_PCB
