EVR-Tuiasi/Shield_VCU_Board/(list of files, cad)

Other CAD files:
Shield_VCU_Board/8.3D/Shield_VCU_Boardv2.1.step
