EVR-Tuiasi/Shield_VCU_Board/Shield_VCU_Board/3.Simulations/NMOS_STATE_LED_Results.jpg

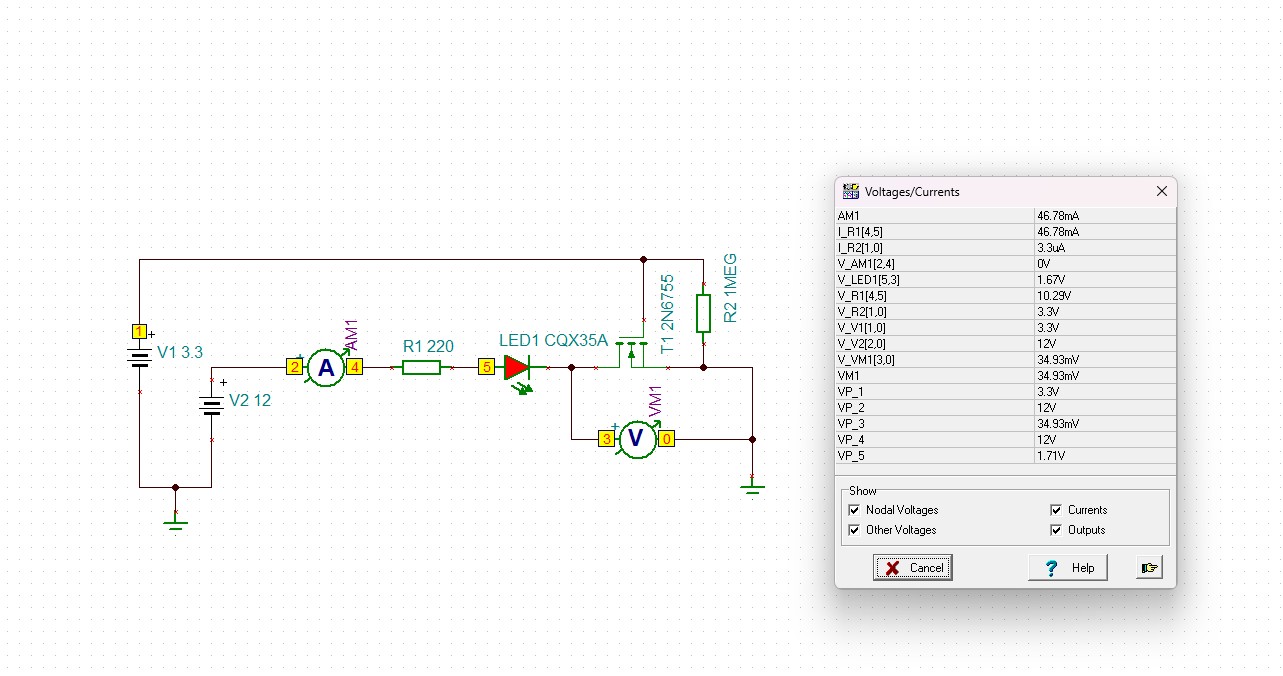
Shield_VCU_Board/3.Simulations/NMOS_STATE_LED_Results.jpg
