EVR-Tuiasi/Shield_VCU_Board/Shield_VCU_Board/3.Simulations/Power_ON5V_simulation(notGoodResult).jpg

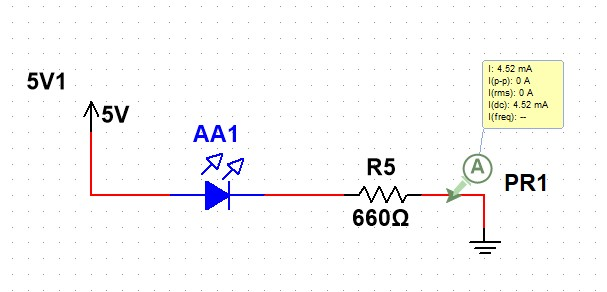
Shield_VCU_Board/3.Simulations/Power_ON5V_simulation(notGoodResult).jpg
