EVR-Tuiasi/Shield_VCU_Board/Shield_VCU_Board/Issues.txt

Probleme:
-Main connector pitch 2mm - not good, need 2.5mm - Done
- main connector protection diode wrong footprint;actual diode much bigger; - Done
- Display touchscreen connector pin swapped (Corrected!);
- Diode D16, wrong part ordered pr wrong footprint; - Done
- Inductor 10mH , wrong part ordered or wrong footprint assigned; - Done

- BAT+ to 3.3 & 5V need a better solution in order to avoid overheat of the LDOs - In progress
 - All diodes need to be verified and selected appropriate to their task;
