EVR-Tuiasi/Shield_VCU_Board/Shield_VCU_Board/7.Documentation/E-Scheme_V1.0.pdf

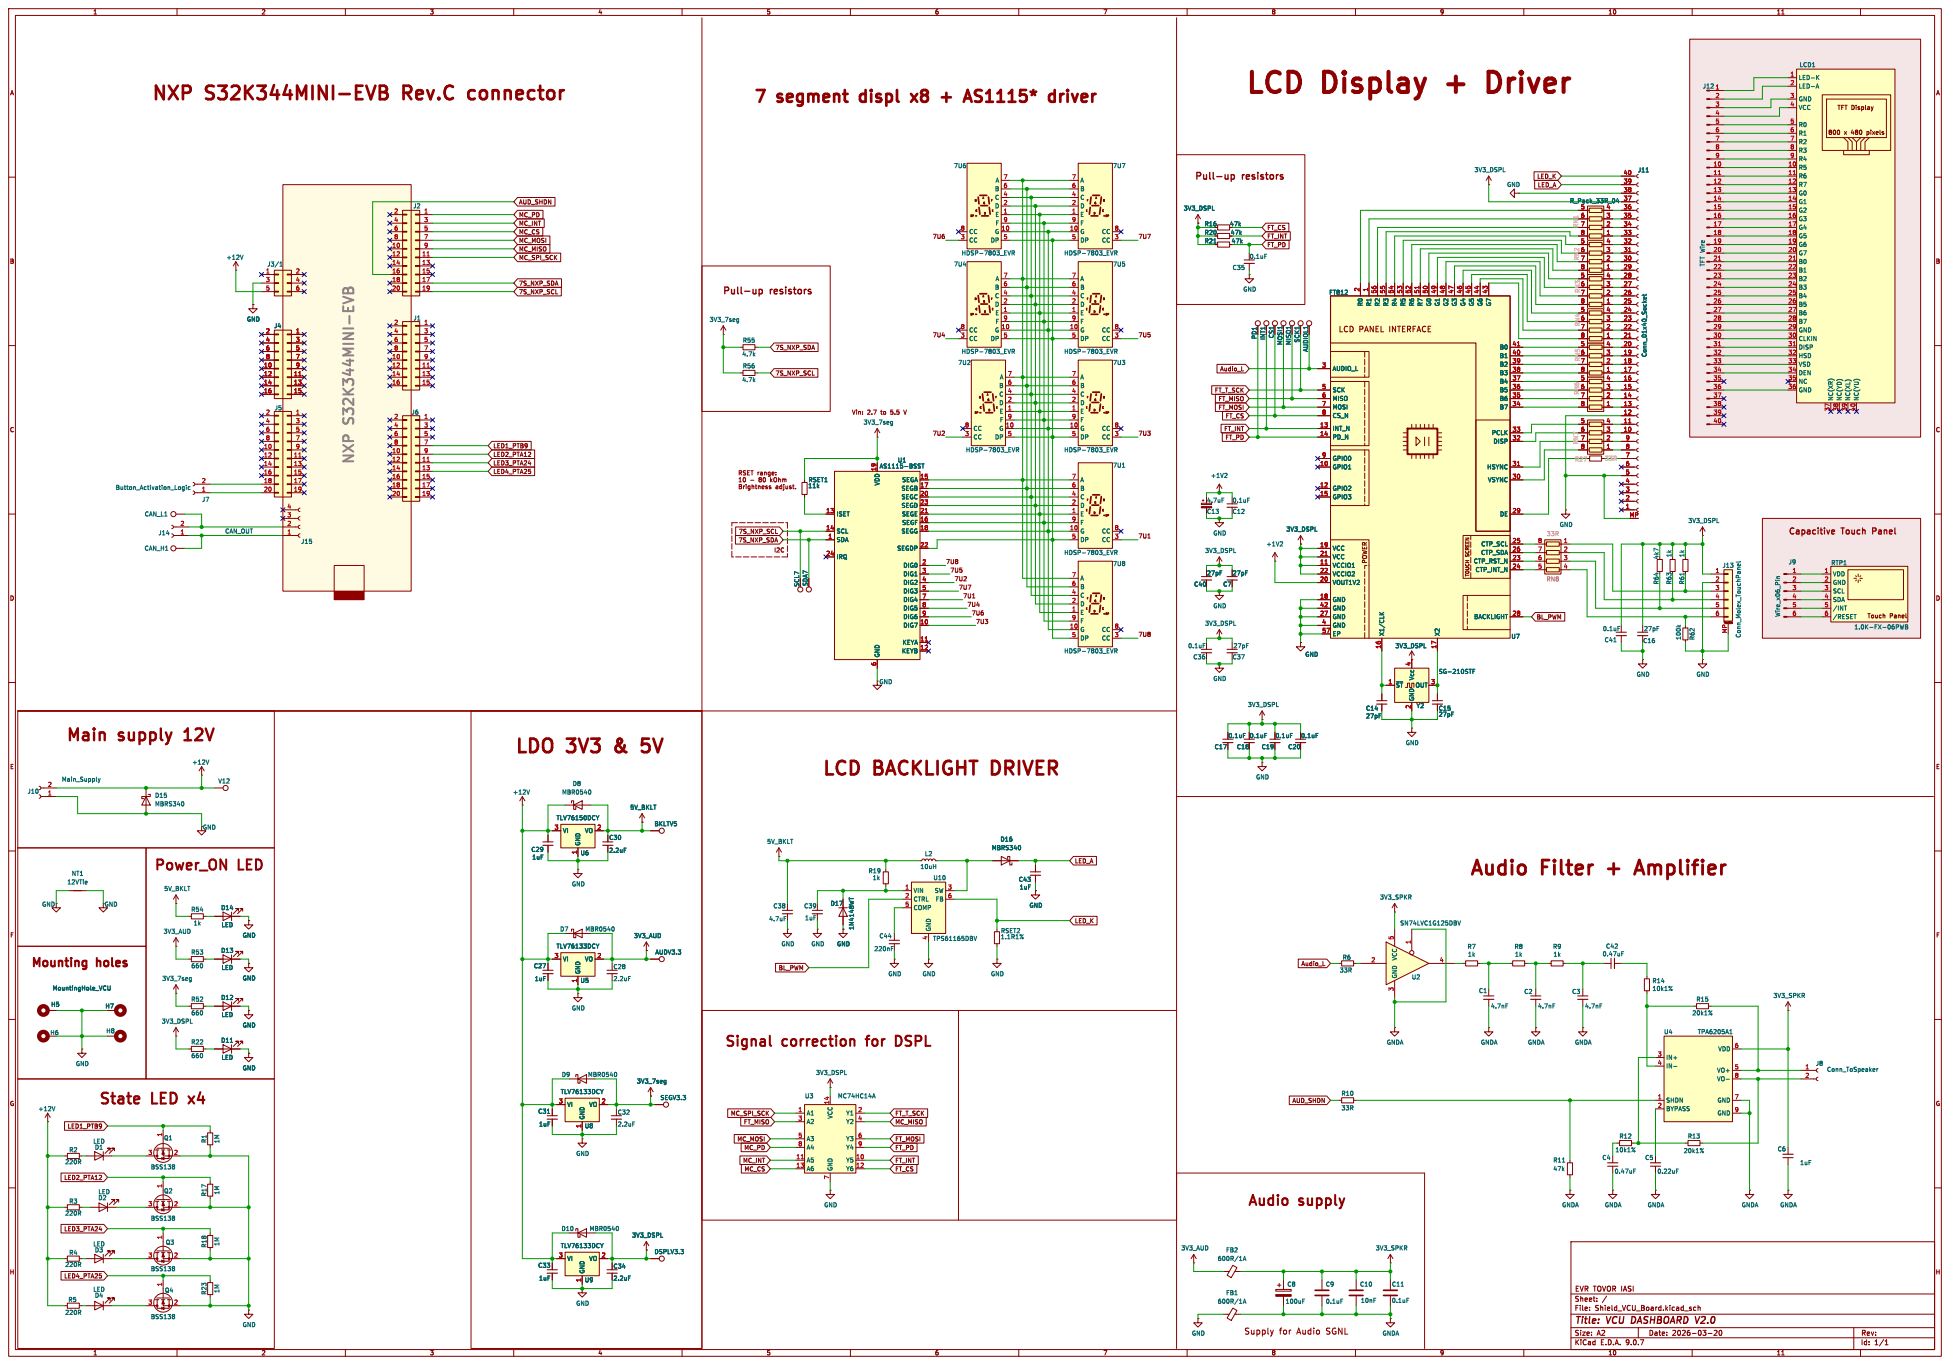
[picture p13: page 1]

6 SEGA 15 SEGB 17 SEGC 20 SEGD 23 SEGE 21 SEGF 16 SEGG 18 SEGDP 22 DIG0 2 DIG1 3 DIG2 4 DIG3 5 DIG4 7 DIG5 8 DIG6 9 DIG7 10 KEYA 11 KEYB 12 U1 AS1115-BSST SDA7

6 SEGA 15 SEGB 17 SEGC 20 SEGD 23 SEGE 21 SEGF 16 SEGG 18 SEGDP 22 DIG0 2 DIG1 3 DIG2 4 DIG3 5 DIG4 7 DIG5 8 DIG6 9 DIG7 10 KEYA 11 KEYB 12 SCL7 SDA7 RSET1

Signal correction for DSPL

Supply for Audio SGNL
