EVR-Tuiasi/Shield_VCU_Board/(list of files, drawings)

Other design files:
Shield_VCU_Board/2.DataSheets/S32K344MINI-EVB_HWPackage/Rev. B1/S32K344MINI_RevB1_Schematic.DSN
Shield_VCU_Board/2.DataSheets/S32K344MINI-EVB_HWPackage/Rev. C/S32K344MINI_RevC_Schematic.DSN
Shield_VCU_Board/3.Simulations/Filter-Capacitance Multiplier.ms14
Shield_VCU_Board/3.Simulations/SandBox.ms14
