EVR-Tuiasi/Shield_VCU_Board/Shield_VCU_Board/1.KiCad/Shield_VCU_Board.kicad_pcb

## KiCad design Shield_VCU_Board/1.KiCad/Shield_VCU_Board.kicad_pcb (2026-06-26)

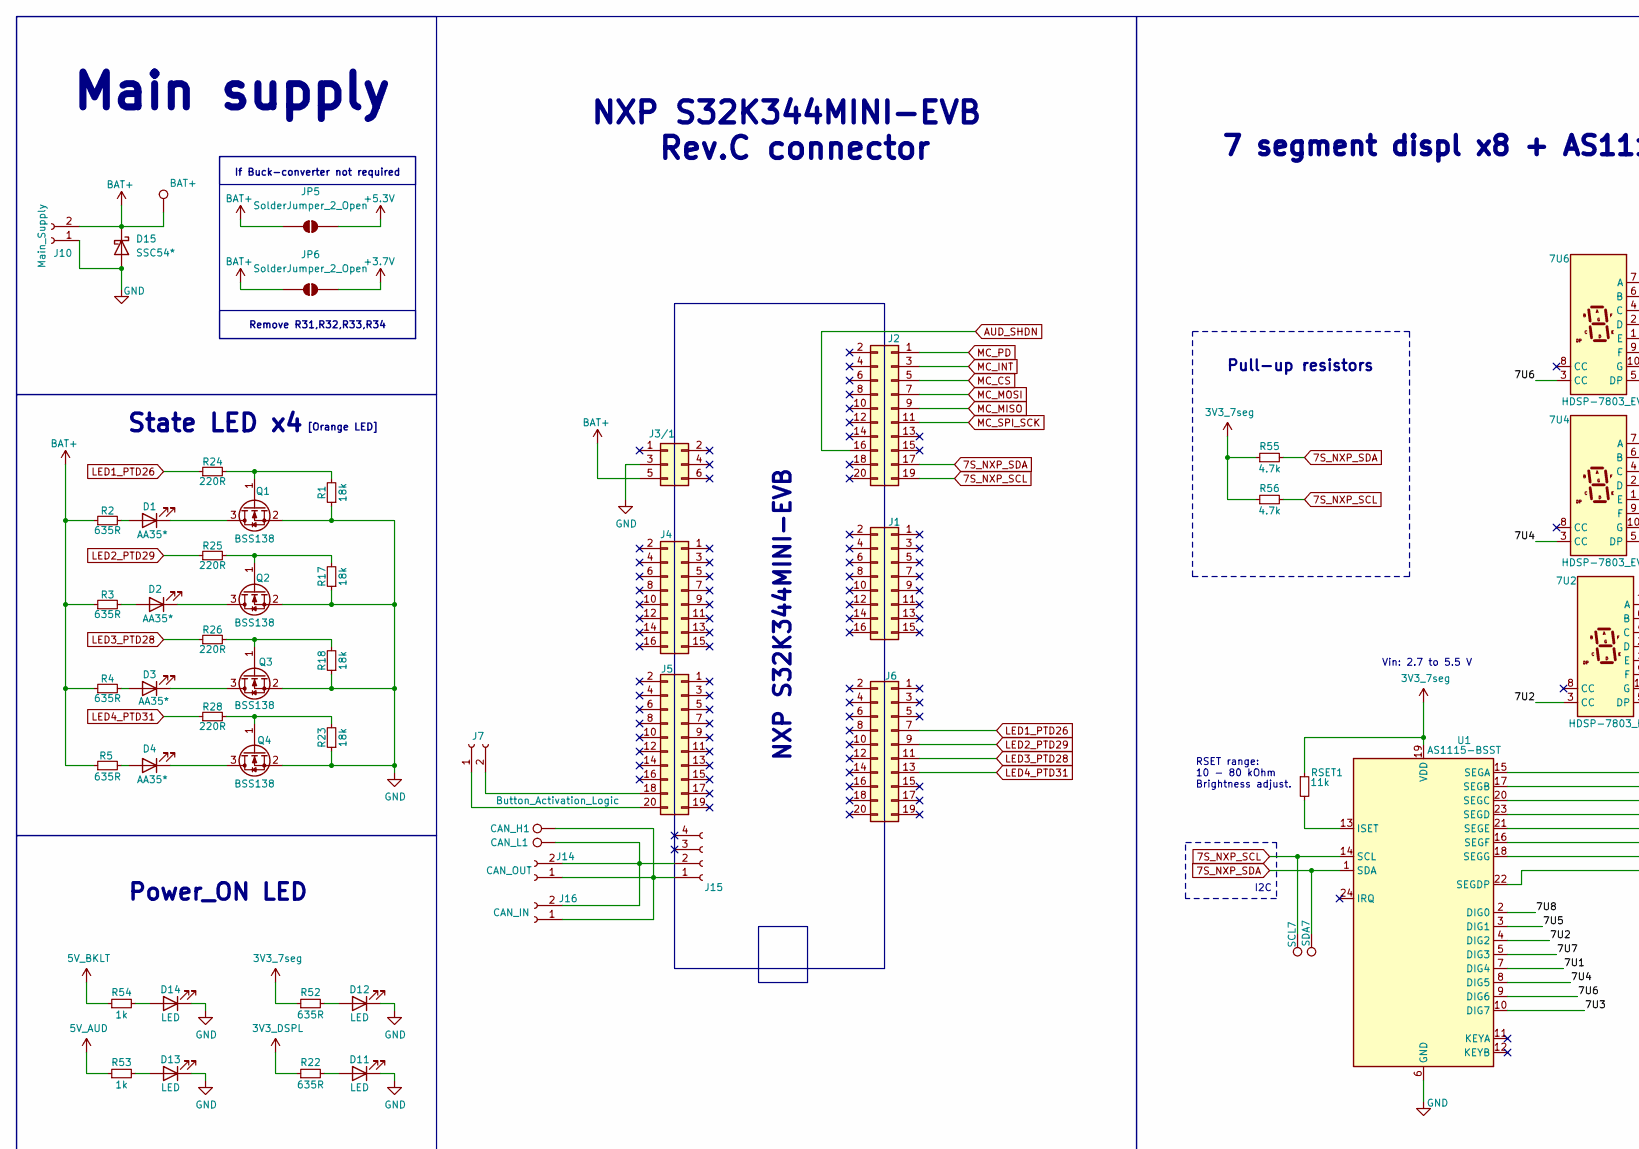
[picture p14: schematic Shield_VCU_Board.kicad_sch, VCU DASHBOARD V2.0, part in row 1, column 1]

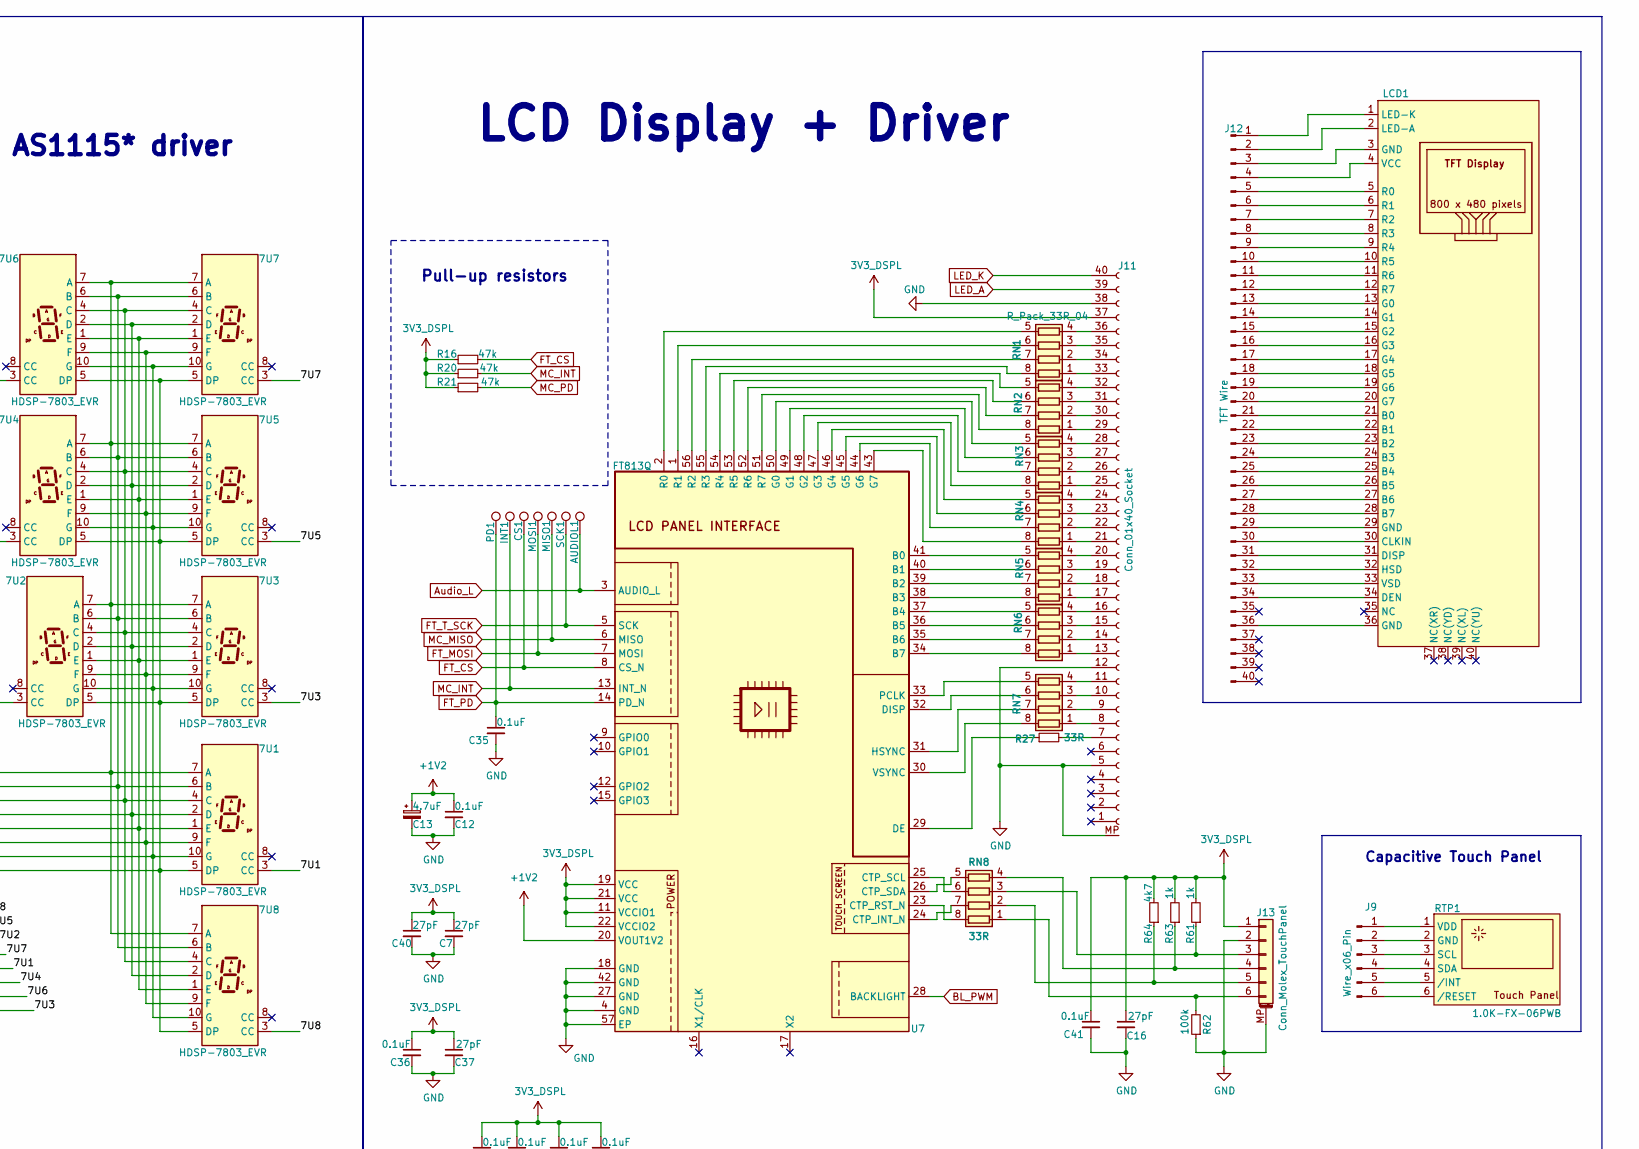
[picture p15: schematic Shield_VCU_Board.kicad_sch, VCU DASHBOARD V2.0, part in row 1, column 2]

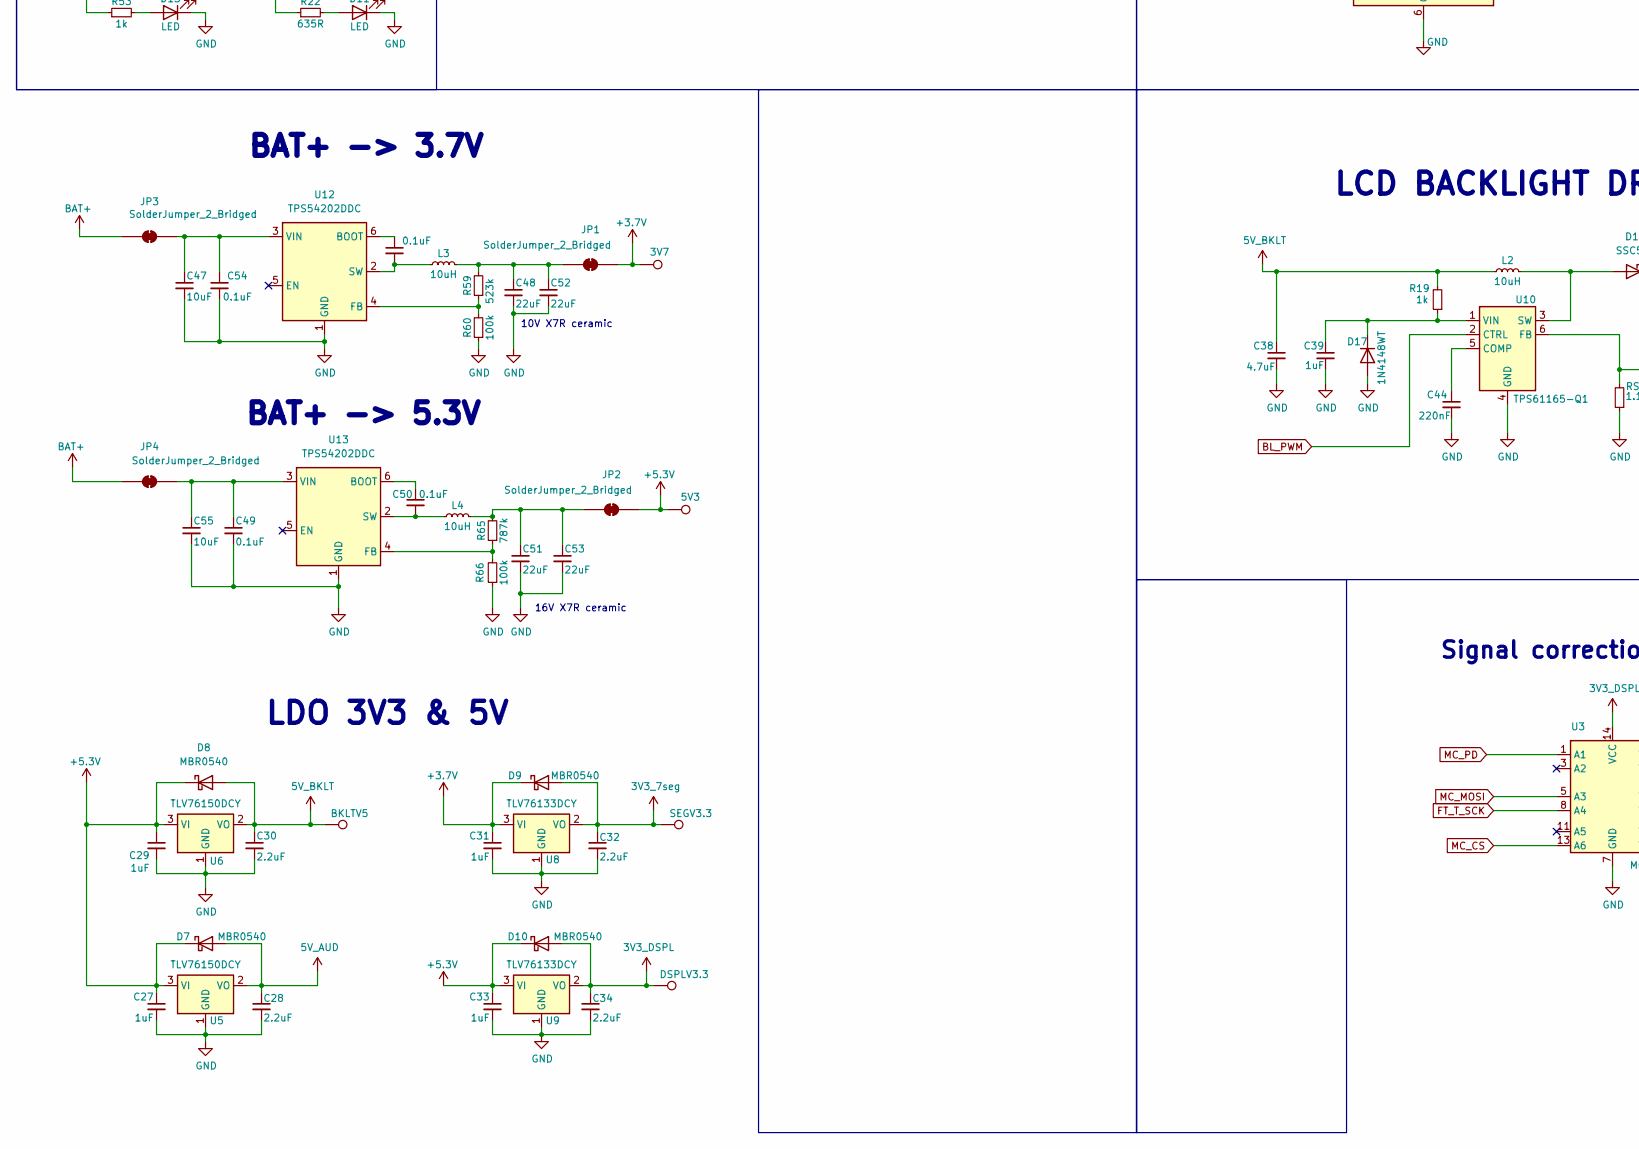
[picture p16: schematic Shield_VCU_Board.kicad_sch, VCU DASHBOARD V2.0, part in row 2, column 1]

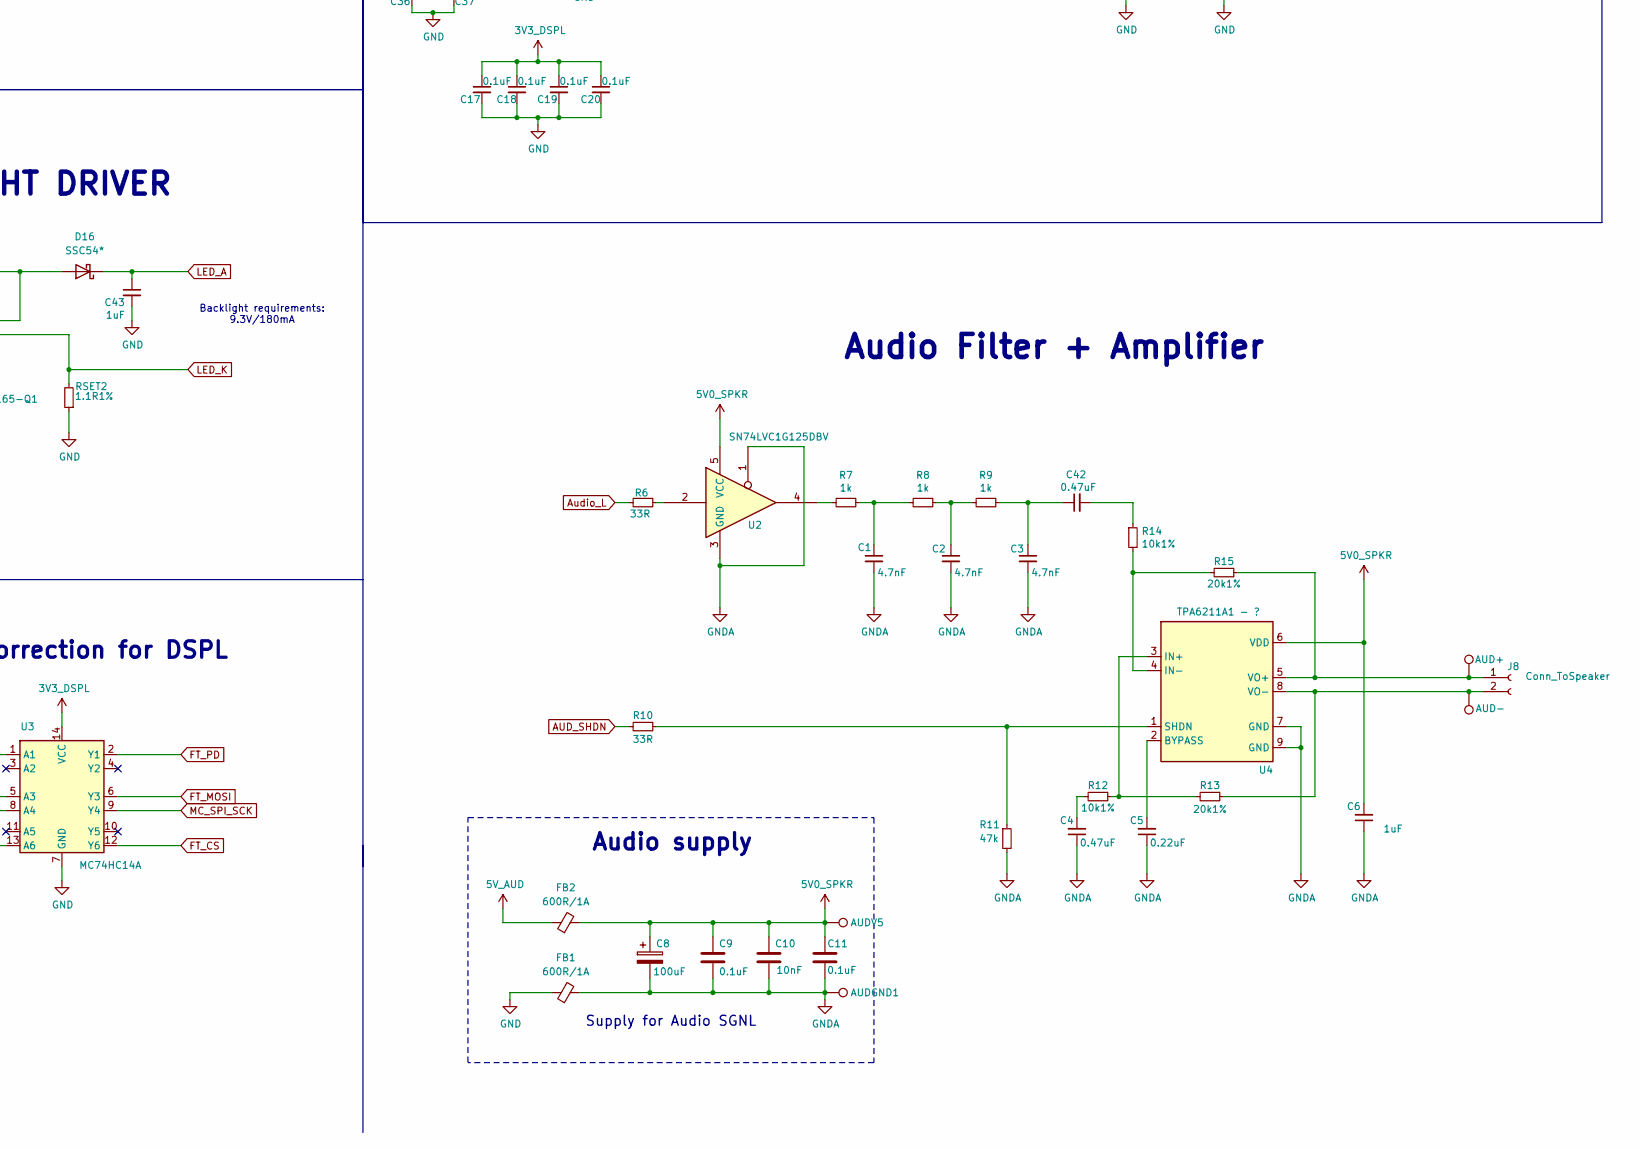
[picture p17: schematic Shield_VCU_Board.kicad_sch, VCU DASHBOARD V2.0, part in row 2, column 2]

Parts:
3V7: 3V7; TestPoint_Pad_D1.0mm
5V3: 5V3; TestPoint_Pad_D1.0mm
7U1, 7U2, 7U3, 7U4, 7U5, 7U6, 7U7, 7U8: HDSP-7803_EVR; T7DS052BC
AUD+01: AUD+; TestPoint_Pad_D1.0mm
AUD-01: AUD-; TestPoint_Pad_D1.0mm
AUDGND1: TestPoint; TestPoint_Pad_D1.0mm
AUDIOL1: TestPoint; TestPoint_Pad_D1.0mm
AUDV5: TestPoint; TestPoint_Pad_D1.0mm
BAT+01: BAT+; TestPoint_Pad_D1.0mm
BKLTV5: TestPoint; TestPoint_Pad_D1.0mm
C1, C2, C3: 4.7nF; C_0805_2012Metric_Pad1.18x1.45mm_HandSolder
C4, C42: 0.47uF; C_0805_2012Metric_Pad1.18x1.45mm_HandSolder
C5: 0.22uF; C_0805_2012Metric_Pad1.18x1.45mm_HandSolder
C6, C27, C29, C31, C33, C39, C43: 1uF; C_0805_2012Metric_Pad1.18x1.45mm_HandSolder
C7, C16, C37, C40: 27pF; C_0805_2012Metric_Pad1.18x1.45mm_HandSolder
C8: 100uF; CP_Elec_5x5.4
C9, C11, C12, C17, C18, C19, C20, C35, C36, C41, C45, C49, C50, C54: 0.1uF; C_0805_2012Metric_Pad1.18x1.45mm_HandSolder
C10: 10nF; C_0805_2012Metric_Pad1.18x1.45mm_HandSolder
C13: 4.7uF; CP_EIA-2012-12_Kemet-R_HandSolder
C28, C30, C32, C34: 2.2uF; C_0805_2012Metric_Pad1.18x1.45mm_HandSolder
C38: 4.7uF; C_0805_2012Metric_Pad1.18x1.45mm_HandSolder
C44: 220nF; C_0805_2012Metric_Pad1.18x1.45mm_HandSolder
C47, C55: 10uF; C_1210_3225Metric_Pad1.33x2.70mm_HandSolder
C48, C51, C52, C53: 22uF; C_1210_3225Metric_Pad1.33x2.70mm_HandSolder
CAN_H1: TestPoint; TestPoint_Pad_D1.0mm
CAN_L1: TestPoint; TestPoint_Pad_D1.0mm
CS1: TestPoint; TestPoint_Pad_D1.0mm
D1, D2, D3, D4: AA35*; LED_Cree-PLCC4_3.2x2.8mm_CCW_Orange
D7, D8, D9, D10: MBR0540; D_SOD-123
D11, D12, D13, D14: LED; LED_0805_2012Metric
D15, D16: SSC54*; D_SMC
D17: 1N4148WT; D_SOD-123
DSPLV3.3: TestPoint; TestPoint_Pad_D1.0mm
FB1, FB2: 600R/1A; L_1206_3216Metric_Pad1.22x1.90mm_HandSolder
INT1: TestPoint; TestPoint_Pad_D1.0mm
J1, J4: Conn_02x08_Odd_Even; PinHeader_2x08_P2.54mm_Vertical_SMD
J2, J5, J6: Conn_02x10_Odd_Even; PinHeader_2x10_P2.54mm_Vertical_SMD
J3/1: NXP3; PinHeader_2x03_P2.54mm_Vertical_SMD
J7: Button_Activation_Logic; JST_PH_B2B-PH-K_1x02_P2.00mm_Vertical
J8: Conn_ToSpeaker; JST_PH_B2B-PH-K_1x02_P2.00mm_Vertical
J9: Wire_x06_Pin
J10: Main_Supply; JST_XH_B2B-XH-A_1x02_P2.50mm_Vertical
J11: Conn_01x40_Socket; Amphenol_F32Q-1A7x1-11040_1x40-1MP_P0.5mm_Horizontal
J12: TFT Wire
J13: Conn_Molex_TouchPanel; Molex_200528-0060_1x06-1MP_P1.00mm_Horizontal
J14: CAN_OUT; JST_PH_B2B-PH-K_1x02_P2.00mm_Vertical
J15: Conn_01x04_Socket; PinHeader_1x04_P2.54mm_Vertical
J16: CAN_IN; JST_PH_B2B-PH-K_1x02_P2.00mm_Vertical
JP1, JP2, JP3, JP4: SolderJumper_2_Bridged; SolderJumper-2_P1.3mm_Open_TrianglePad1.0x1.5mm
JP5, JP6: SolderJumper_2_Open; SolderJumper-2_P1.3mm_Open_TrianglePad1.0x1.5mm
L2: 10uH; L_Pulse_PA4340
L3, L4: 10uH; L_Coilcraft_LPS4018
LCD1: LCD screen
MISO1: TestPoint; TestPoint_Pad_D1.0mm
MOSI1: TestPoint; TestPoint_Pad_D1.0mm
PD1: TestPoint; TestPoint_Pad_D1.0mm
Q1, Q2, Q3, Q4: BSS138; SOT-23
R1, R17, R18, R23: 18k; R_1206_3216Metric_Pad1.30x1.75mm_HandSolder
R2, R3, R4, R5, R22, R52: 635R; R_1206_3216Metric_Pad1.30x1.75mm_HandSolder
R6, R10: 33R; R_1206_3216Metric_Pad1.30x1.75mm_HandSolder
R7, R8, R9, R19, R53, R54, R61, R63: 1k; R_1206_3216Metric_Pad1.30x1.75mm_HandSolder
R11, R16, R20, R21: 47k; R_1206_3216Metric_Pad1.30x1.75mm_HandSolder
R12, R14: 10k1%; R_1206_3216Metric_Pad1.30x1.75mm_HandSolder
R13, R15: 20k1%; R_1206_3216Metric_Pad1.30x1.75mm_HandSolder
R24, R25, R26, R28: 220R; R_1206_3216Metric_Pad1.30x1.75mm_HandSolder
R27: 33R; R_0603_1608Metric_Pad0.98x0.95mm_HandSolder
R55, R56: 4.7k; R_1206_3216Metric_Pad1.30x1.75mm_HandSolder
R59: 523k; R_1206_3216Metric_Pad1.30x1.75mm_HandSolder
R60, R62, R66: 100k; R_1206_3216Metric_Pad1.30x1.75mm_HandSolder
R64: 4k7; R_1206_3216Metric_Pad1.30x1.75mm_HandSolder
R65: 787k; R_1206_3216Metric_Pad1.30x1.75mm_HandSolder
RN1, RN2, RN3, RN4, RN5, RN6, RN7: R_Pack_33R_04; R_Array_Convex_4x0402
RN8: 33R; R_Cat16-4
RSET1: 11k; R_1206_3216Metric_Pad1.30x1.75mm_HandSolder
RSET2: 1.1R1%; R_1206_3216Metric_Pad1.30x1.75mm_HandSolder
RTP1: 1.0K-FX-06PWB
SCK1: TestPoint; TestPoint_Pad_D1.0mm
SCL7: TestPoint; TestPoint_Pad_D1.0mm
SDA7: TestPoint; TestPoint_Pad_D1.0mm
SEGV3.3: TestPoint; TestPoint_Pad_D1.0mm
U1: AS1115-BSST; QSOP-24_3.9x8.7mm_P0.635mm
U2: SN74LVC1G125DBV; SOT-23-5
U3: MC74HC14A; SOIC-14_3.9x8.7mm_P1.27mm
U4: TPA6211A1 - ?; SOP65P490X110-9L
U5, U6: TLV76150DCY; SOT-223-3_TabPin2
U7: FT813Q; LFCSP-56-1EP_8x8mm_P0.5mm_EP6.6x6.6mm
U8, U9: TLV76133DCY; SOT-223-3_TabPin2
U10: TPS61165-Q1; SOT-23-6
U12, U13: TPS54202DDC; SOT-23-6

Connections:
3V3_7seg: C32.1, D9.2 (A), R52.1, R55.1, R56.1, RSET1.1, SEGV3.3.1 (1_1), U1.19 (VDD), U8.2 (VO)
3V3_DSPL: C7.1, C16.1, C17.1, C18.1, C19.1, C20.1, C34.1, C36.1, C37.1, C40.1, C41.1, D10.2 (A), DSPLV3.3.1 (1_1), J11.37 (Pin_4), J13.1, R16.1, R20.1, R21.1, R22.1, R61.2, R63.2, R64.2, U3.14 (VCC), U7.11 (VCCIO1), U7.19 (VCC), U7.21 (VCC), U7.22 (VCCIO2), U9.2 (VO)
5V0_SPKR: AUDV5.1 (1_1), C6.2, C8.1, C9.2, C10.2, C11.2, FB2.2, U2.5 (VCC), U4.6 (VDD)
5V_AUD: C28.1, D7.2 (A), FB2.1, R53.1, U5.2 (VO)
5V_BKLT: BKLTV5.1 (1_1), C30.1, C38.1, D8.2 (A), L2.1, R19.2, R54.1, U6.2 (VO)
7S_NXP_SCL: J2.19, R56.2, SCL7.1 (1_1), U1.14 (SCL)
7S_NXP_SDA: J2.17, R55.2, SDA7.1 (1_1), U1.1 (SDA)
+1V2: C12.1, C13.1, U7.20 (VOUT1V2)
+3.7V: 3V7.1 (1_1), C31.1, D9.1 (K), JP1.2 (B), JP6.2 (B), U8.3 (VI)
+5.3V: 5V3.1 (1_1), C27.1, C29.1, C33.1, D7.1 (K), D8.1 (K), D10.1 (K), JP2.2 (B), JP5.2 (B), U5.3 (VI), U6.3 (VI), U9.3 (VI)
/7U1: 7U1.3 (CC), U1.7 (DIG4)
/7U2: 7U2.3 (CC), U1.4 (DIG2)
/7U3: 7U3.3 (CC), U1.10 (DIG7)
/7U4: 7U4.3 (CC), U1.8 (DIG5)
/7U5: 7U5.3 (CC), U1.3 (DIG1)
/7U6: 7U6.3 (CC), U1.9 (DIG6)
/7U7: 7U7.3 (CC), U1.5 (DIG3)
/7U8: 7U8.3 (CC), U1.2 (DIG0)
AUD_SHDN: J2.16, R10.2
Audio_L: AUDIOL1.1 (1_1), R6.2, U7.3 (AUDIO_L)
BAT+: BAT+01.1 (1_1), D15.1 (K), J3/1.5, J10.2, JP3.1 (A), JP4.1 (A), JP5.1 (A), JP6.1 (A), R2.1, R3.1, R4.1, R5.1
BL_PWM: U7.28 (BACKLIGHT), U10.2 (CTRL)
FT_CS: CS1.1 (1_1), R16.2, U3.12 (Y6), U7.8 (CS_N)
FT_MOSI: MOSI1.1 (1_1), U3.6 (Y3), U7.7 (MOSI)
FT_PD: C35.1, PD1.1 (1_1), U3.2 (Y1), U7.14 (PD_N)
FT_T_SCK: SCK1.1 (1_1), U3.8 (A4), U7.5 (SCK)
GND: C7.2, C12.2, C13.2, C16.2, C17.2, C18.2, C19.2, C20.2, C27.2, C28.2, C29.2, C30.2, C31.2, C32.2, C33.2, C34.2, C35.2, C36.2, C37.2, C38.2, C39.2, C40.2, C41.2, C43.2, C44.2, C47.2, C48.2, C49.2, C51.2, C52.2, C53.2, C54.2, C55.2, D11.1 (K), D12.1 (K), D13.1 (K), D14.1 (K), D15.2 (A), D17.2 (A), FB1.1, J3/1.3, J10.1, J11.5 (Pin_36), J11.12 (Pin_29), J11.38 (Pin_3), J11.MP, J13.2, J13.MP (MountPin), Q1.2 (S), Q2.2 (S), Q3.2 (S), Q4.2 (S), R1.1, R17.1, R18.1, R23.1, R60.1, R62.1, R66.1, RSET2.1, U1.6 (GND), U3.7 (GND), U5.1 (GND), U6.1 (GND), U7.4 (GND), U7.18 (GND), U7.27 (GND), U7.42 (GND), U7.57 (EP), U8.1 (GND), U9.1 (GND), U10.4 (GND), U12.1 (GND), U13.1 (GND)
GNDA: AUDGND1.1 (1_1), C1.2, C2.2, C3.2, C4.1, C5.1, C6.1, C8.2, C9.1, C10.1, C11.1, FB1.2, R11.2, U2.1, U2.3 (GND), U4.7 (GND), U4.9 (GND)
LED1_PTD26: J6.7, R24.1
LED2_PTD29: J6.9, R25.1
LED3_PTD28: J6.11, R26.1
LED4_PTD31: J6.13, R28.1
LED_A: C43.1, D16.1 (K), J11.39 (Pin_2)
LED_K: J11.40 (Pin_1), RSET2.2, U10.6 (FB)
MC_CS: J2.5, U3.13 (A6)
MC_INT: INT1.1 (1_1), J2.3, R20.2, U7.13 (INT_N)
MC_MISO: J2.9, MISO1.1 (1_1), U7.6 (MISO)
MC_MOSI: J2.7, U3.5 (A3)
MC_PD: J2.1, R21.2, U3.1 (A1)
MC_SPI_SCK: J2.11, U3.9 (Y4)
unnamed: 7U1.7 (A), 7U2.7 (A), 7U3.7 (A), 7U4.7 (A), 7U5.7 (A), 7U6.7 (A), 7U7.7 (A), 7U8.7 (A), U1.15 (SEGA)
unnamed: 7U1.6 (B), 7U2.6 (B), 7U3.6 (B), 7U4.6 (B), 7U5.6 (B), 7U6.6 (B), 7U7.6 (B), 7U8.6 (B), U1.17 (SEGB)
unnamed: 7U1.4 (C), 7U2.4 (C), 7U3.4 (C), 7U4.4 (C), 7U5.4 (C), 7U6.4 (C), 7U7.4 (C), 7U8.4 (C), U1.20 (SEGC)
unnamed: 7U1.2 (D), 7U2.2 (D), 7U3.2 (D), 7U4.2 (D), 7U5.2 (D), 7U6.2 (D), 7U7.2 (D), 7U8.2 (D), U1.23 (SEGD)
unnamed: 7U1.5 (DP), 7U2.5 (DP), 7U3.5 (DP), 7U4.5 (DP), 7U5.5 (DP), 7U6.5 (DP), 7U7.5 (DP), 7U8.5 (DP), U1.22 (SEGDP)
unnamed: 7U1.1 (E), 7U2.1 (E), 7U3.1 (E), 7U4.1 (E), 7U5.1 (E), 7U6.1 (E), 7U7.1 (E), 7U8.1 (E), U1.21 (SEGE)
unnamed: 7U1.9 (F), 7U2.9 (F), 7U3.9 (F), 7U4.9 (F), 7U5.9 (F), 7U6.9 (F), 7U7.9 (F), 7U8.9 (F), U1.16 (SEGF)
unnamed: 7U1.10 (G), 7U2.10 (G), 7U3.10 (G), 7U4.10 (G), 7U5.10 (G), 7U6.10 (G), 7U7.10 (G), 7U8.10 (G), U1.18 (SEGG)
unnamed: C1.1, R7.1, R8.2
unnamed: C2.1, R8.1, R9.2
unnamed: C3.1, C42.1, R9.1
unnamed: C4.2, R12.2
unnamed: C42.2, R14.1
unnamed: D1.2 (A), R2.2
unnamed: D1.1 (K), Q1.3 (D)
unnamed: D2.2 (A), R3.2
unnamed: D2.1 (K), Q2.3 (D)
unnamed: D3.2 (A), R4.2
unnamed: D3.1 (K), Q3.3 (D)
unnamed: D4.2 (A), R5.2
unnamed: D4.1 (K), Q4.3 (D)
unnamed: D11.2 (A), R22.2
unnamed: D12.2 (A), R52.2
unnamed: D13.2 (A), R53.2
unnamed: D14.2 (A), R54.2
unnamed: D16.2 (A), L2.2, U10.3 (SW)
unnamed: C39.1, D17.1 (K), R19.1, U10.1 (VIN)
unnamed: J5.18, J7.2
unnamed: J5.20, J7.1
unnamed: AUD+01.1 (1_1), J8.1, R15.1, U4.5 (VO+)
unnamed: AUD-01.1 (1_1), J8.2, R13.1, U4.8 (VO-)
unnamed: J9.1, RTP1.1 (VDD)
unnamed: J9.2, RTP1.2 (GND)
unnamed: J9.3, RTP1.3 (SCL)
unnamed: J9.4, RTP1.4 (SDA)
unnamed: J9.5, RTP1.5 (/INT)
unnamed: J9.6, RTP1.6 (/RESET)
unnamed: J11.36 (Pin_5), RN1.4 (R4.1)
unnamed: J11.35 (Pin_6), RN1.3 (R3.1)
unnamed: J11.34 (Pin_7), RN1.2 (R2.1)
unnamed: J11.33 (Pin_8), RN1.1 (R1.1)
unnamed: J11.32 (Pin_9), RN2.4 (R4.1)
unnamed: J11.31 (Pin_10), RN2.3 (R3.1)
unnamed: J11.30 (Pin_11), RN2.2 (R2.1)
unnamed: J11.29 (Pin_12), RN2.1 (R1.1)
unnamed: J11.28 (Pin_13), RN3.4 (R4.1)
unnamed: J11.27 (Pin_14), RN3.3 (R3.1)
unnamed: J11.26 (Pin_15), RN3.2 (R2.1)
unnamed: J11.25 (Pin_16), RN3.1 (R1.1)
unnamed: J11.24 (Pin_17), RN4.4 (R4.1)
unnamed: J11.23 (Pin_18), RN4.3 (R3.1)
unnamed: J11.22 (Pin_19), RN4.2 (R2.1)
unnamed: J11.21 (Pin_20), RN4.1 (R1.1)
unnamed: J11.20 (Pin_21), RN5.4 (R4.1)
unnamed: J11.19 (Pin_22), RN5.3 (R3.1)
unnamed: J11.18 (Pin_23), RN5.2 (R2.1)
unnamed: J11.17 (Pin_24), RN5.1 (R1.1)
unnamed: J11.16 (Pin_25), RN6.4 (R4.1)
unnamed: J11.15 (Pin_26), RN6.3 (R3.1)
unnamed: J11.14 (Pin_27), RN6.2 (R2.1)
unnamed: J11.13 (Pin_28), RN6.1 (R1.1)
unnamed: J11.11 (Pin_30), RN7.4 (R4.1)
unnamed: J11.10 (Pin_31), RN7.3 (R3.1)
unnamed: J11.9 (Pin_32), RN7.2 (R2.1)
unnamed: J11.8 (Pin_33), RN7.1 (R1.1)
unnamed: J11.7 (Pin_34), R27.2
unnamed: J12.1, LCD1.1 (LED-K)
unnamed: J12.2, LCD1.2 (LED-A)
unnamed: J12.3, LCD1.3 (GND)
unnamed: J12.4, LCD1.4 (VCC)
unnamed: J12.5, LCD1.5 (R0)
unnamed: J12.6, LCD1.6 (R1)
unnamed: J12.7, LCD1.7 (R2)
unnamed: J12.8, LCD1.8 (R3)
unnamed: J12.9, LCD1.9 (R4)
unnamed: J12.10, LCD1.10 (R5)
unnamed: J12.11, LCD1.11 (R6)
unnamed: J12.12, LCD1.12 (R7)
unnamed: J12.13, LCD1.13 (G0)
unnamed: J12.14, LCD1.14 (G1)
unnamed: J12.15, LCD1.15 (G2)
unnamed: J12.16, LCD1.16 (G3)
unnamed: J12.17, LCD1.17 (G4)
unnamed: J12.18, LCD1.18 (G5)
unnamed: J12.19, LCD1.19 (G6)
unnamed: J12.20, LCD1.20 (G7)
unnamed: J12.21, LCD1.21 (B0)
unnamed: J12.22, LCD1.22 (B1)
unnamed: J12.23, LCD1.23 (B2)
unnamed: J12.24, LCD1.24 (B3)
unnamed: J12.25, LCD1.25 (B4)
unnamed: J12.26, LCD1.26 (B5)
unnamed: J12.27, LCD1.27 (B6)
unnamed: J12.28, LCD1.28 (B7)
unnamed: J12.29, LCD1.29 (GND)
unnamed: J12.30, LCD1.30 (CLKIN)
unnamed: J12.31, LCD1.31 (DISP)
unnamed: J12.32, LCD1.32 (HSD)
unnamed: J12.33, LCD1.33 (VSD)
unnamed: J12.34, LCD1.34 (DEN)
unnamed: J12.36, LCD1.36 (GND)
unnamed: J13.3, R61.1, RN8.3 (R3.1)
unnamed: J13.4, R63.1, RN8.4 (R4.1)
unnamed: J13.5, R64.1, RN8.2 (R2.1)
unnamed: J13.6, R62.2, RN8.1 (R1.1)
unnamed: CAN_H1.1 (1_1), J14.1, J15.1, J16.1
unnamed: CAN_L1.1 (1_1), J14.2, J15.2, J16.2
unnamed: C48.1, C52.1, JP1.1 (A), L3.2, R59.2
unnamed: C51.1, C53.1, JP2.1 (A), L4.2, R65.2
unnamed: C47.1, C54.1, JP3.2 (B), U12.3 (VIN)
unnamed: C49.1, C55.1, JP4.2 (B), U13.3 (VIN)
unnamed: Q1.1 (G), R1.2, R24.2
unnamed: Q2.1 (G), R17.2, R25.2
unnamed: Q3.1 (G), R18.2, R26.2
unnamed: Q4.1 (G), R23.2, R28.2
unnamed: R6.1, U2.2
unnamed: R7.2, U2.4
unnamed: RN1.8 (R1.2), U7.55 (R3)
unnamed: RN1.7 (R2.2), U7.56 (R2)
unnamed: RN1.6 (R3.2), U7.1 (R1)
unnamed: RN1.5 (R4.2), U7.2 (R0)
unnamed: RN2.8 (R1.2), U7.51 (R7)
unnamed: RN2.7 (R2.2), U7.52 (R6)
unnamed: RN2.6 (R3.2), U7.53 (R5)
unnamed: RN2.5 (R4.2), U7.54 (R4)
unnamed: RN3.8 (R1.2), U7.47 (G3)
unnamed: RN3.7 (R2.2), U7.48 (G2)
unnamed: RN3.6 (R3.2), U7.49 (G1)
unnamed: RN3.5 (R4.2), U7.50 (G0)
unnamed: RN4.8 (R1.2), U7.43 (G7)
unnamed: RN4.7 (R2.2), U7.44 (G6)
unnamed: RN4.6 (R3.2), U7.45 (G5)
unnamed: RN4.5 (R4.2), U7.46 (G4)
unnamed: RN5.8 (R1.2), U7.38 (B3)
unnamed: RN5.7 (R2.2), U7.39 (B2)
unnamed: RN5.6 (R3.2), U7.40 (B1)
unnamed: RN5.5 (R4.2), U7.41 (B0)
unnamed: RN6.8 (R1.2), U7.34 (B7)
unnamed: RN6.7 (R2.2), U7.35 (B6)
unnamed: RN6.6 (R3.2), U7.36 (B5)
unnamed: RN6.5 (R4.2), U7.37 (B4)
unnamed: RN7.8 (R1.2), U7.30 (VSYNC)
unnamed: RN7.7 (R2.2), U7.31 (HSYNC)
unnamed: RN7.6 (R3.2), U7.32 (DISP)
unnamed: RN7.5 (R4.2), U7.33 (PCLK)
unnamed: RN8.8 (R1.2), U7.23 (CTP_RST_N)
unnamed: RN8.7 (R2.2), U7.24 (CTP_INT_N)
unnamed: RN8.6 (R3.2), U7.25 (CTP_SCL)
unnamed: RN8.5 (R4.2), U7.26 (CTP_SDA)
unnamed: RSET1.2, U1.13 (ISET)
unnamed: C5.2, U4.2 (BYPASS)
unnamed: R12.1, R13.2, U4.3 (IN+)
unnamed: R14.2, R15.2, U4.4 (IN-)
unnamed: R10.1, R11.1, U4.1 (SHDN)
unnamed: R27.1, U7.29 (DE)
unnamed: C44.1, U10.5 (COMP)
unnamed: C45.1, U12.6 (BOOT)
unnamed: R59.1, R60.2, U12.4 (FB)
unnamed: C45.2, L3.1, U12.2 (SW)
unnamed: C50.1, U13.6 (BOOT)
unnamed: R65.1, R66.2, U13.4 (FB)
unnamed: C50.2, L4.1, U13.2 (SW)

Notes on the sheet:
LDO 3V3 & 5V
If Buck-converter not required
Capacitive Touch Panel
BAT+ -> 3.7V
Vin: 2.7 to 5.5 V
Pull-up resistors
NXP S32K344MINI-EVB Rev.C connector
State LED x4
Backlight requirements: 9.3V/180mA
LCD BACKLIGHT DRIVER
Audio supply
BAT+ -> 5.3V
Signal correction for DSPL
Remove R31,R32,R33,R34
LCD Display + Driver
16V X7R ceramic
Audio Filter + Amplifier
7 segment displ x8 + AS1115* driver
Power_ON LED
10V X7R ceramic
I2C
NXP S32K344MINI-EVB
Main supply
Supply for Audio SGNL
RSET range: 10 - 80 kOhm Brightness adjust.
[Orange LED]

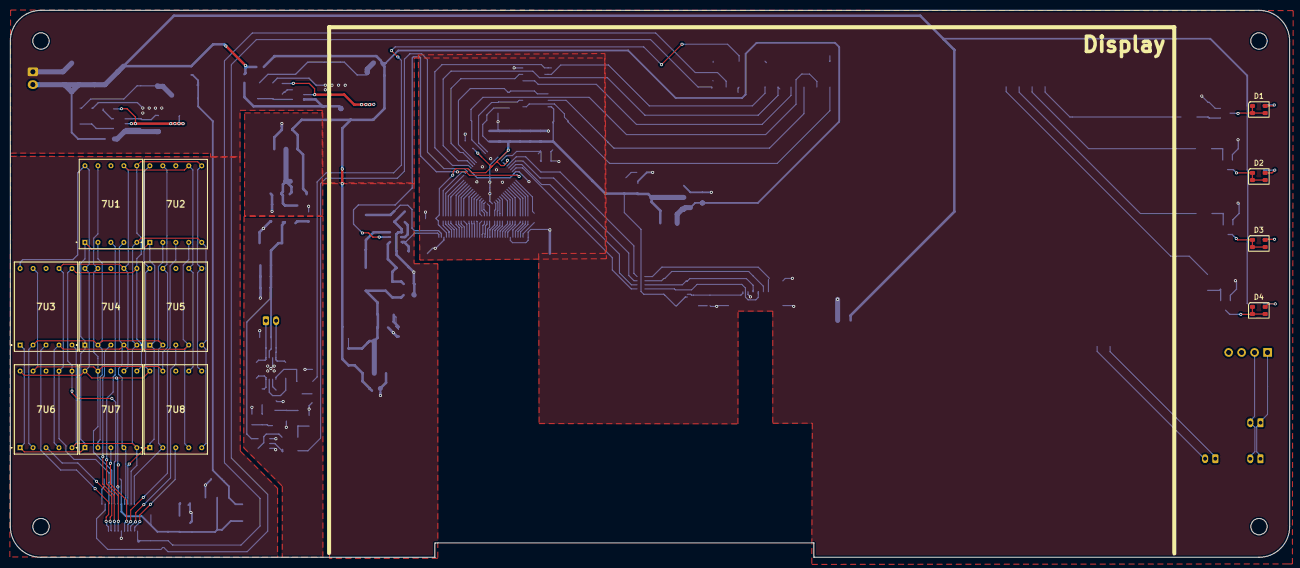
[picture p18: board Shield_VCU_Board.kicad_pcb from above]

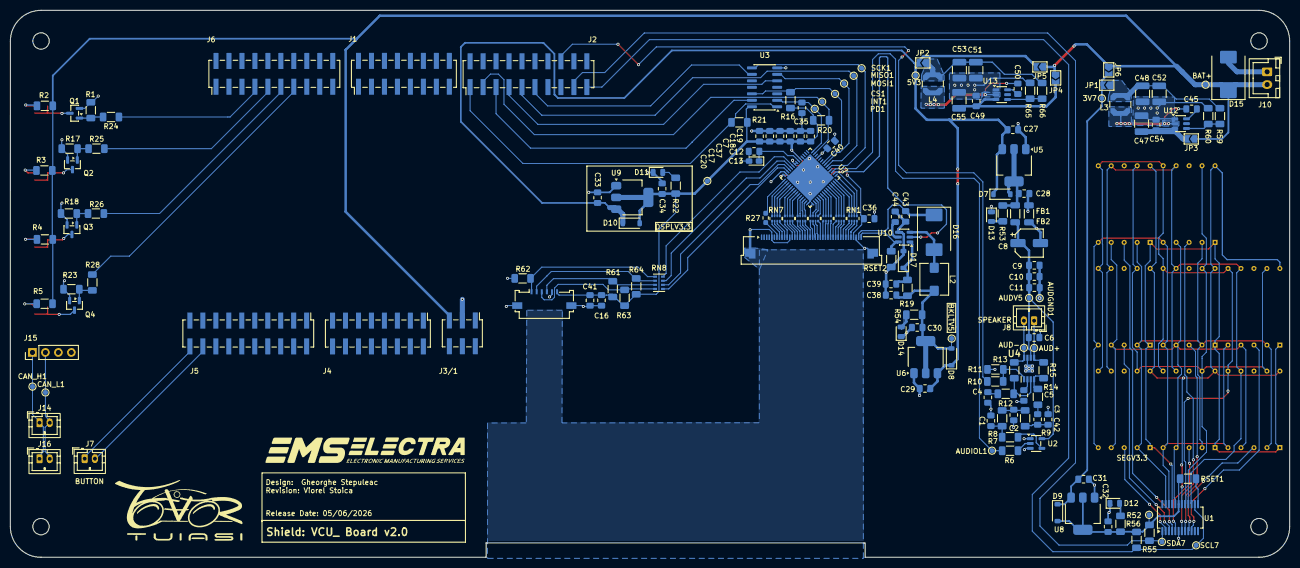
[picture p19: board Shield_VCU_Board.kicad_pcb from below]

Board: 2 copper layers, 250.5 x 107.1 mm, 182 parts (170 on the bottom side), 161 nets.
