EVR-Tuiasi/Shield_VCU_Board/(commit log)

2026-02-15 creare proiect
    [Shield_VCU_Board.kicad_pcb, Shield_VCU_Board.kicad_sch]
2026-02-15 Conectori pe schematic
    [Shield_VCU_Board.kicad_sch]
2026-02-15 Added 7segDispl parts
    [Shield_VCU_Board.kicad_sch]
2026-02-17 Added LDO + LCD
    [Shield_VCU_Board.kicad_sch]
2026-02-17 Updated NXP scheme
    [Shield_VCU_Board.kicad_sch]
2026-02-17 Added Molex Connector
    [Shield_VCU_Board.kicad_sch]
2026-02-17 Added mountingHoles
    [Shield_VCU_Board.kicad_sch]
2026-02-17 Capacitors adjustment
    [Shield_VCU_Board.kicad_sch]
2026-02-17 GPIO corrections
    Sheet is now ready for the first check.
    [Shield_VCU_Board.kicad_sch]
2026-02-19 DSPL update version - Done
    + TestPins added
    [Shield_VCU_Board.kicad_sch]
2026-02-20 Error corrections
    [Shield_VCU_Board.kicad_sch]
2026-02-20 Reverse voltage protection added
    Additional:
    +4 mounting holes
    +corrected 1x resistor value
    +AUD pin connected by J2
    [Shield_VCU_Board.kicad_sch]
2026-02-20 Protection update
    [Shield_VCU_Board.kicad_sch]
2026-02-20 Updated Display Driver pins
    [Shield_VCU_Board.kicad_sch]
2026-02-21 DWG cleanup
    [Shield_VCU_Board.kicad_sch]
2026-02-21 BOM proto created
    bill of materials added without the parts identified
    [Shield_VCU_Board.kicad_sch, Shield_VCU_Board_proto.csv]
2026-02-21 RPP series added
    [Shield_VCU_Board.kicad_sch, Shield_VCU_Board_proto.csv]
2026-02-21 Added proto footprints for Layout
    [Shield_VCU_Board.kicad_sch]
2026-02-21 Layout proto_check
    [Shield_VCU_Board.kicad_pcb, Shield_VCU_Board.kicad_sch]
2026-02-23 New BL chip proto
    New chip is currently placed but surrounding components not fine-selected
    [Shield_VCU_Board.kicad_sch]
2026-02-23 BL drive correction
    [Shield_VCU_Board.kicad_sch]
2026-02-24 PCL_Layout_Arrangements
    Initial PCB components arangement done.
    Not a functional version!
    [Shield_VCU_Board.kicad_pcb, Shield_VCU_Board.kicad_sch]
2026-02-25 Layout_Progress_0.2
    + 7seg x8 Digits connected
    +LDO started
    [Shield_VCU_Board.kicad_pcb, Shield_VCU_Board.kicad_sch]
2026-02-27 VCU components displacement change
    +added NXP Pin locations
    +added precise LCD wire connectors location
    +change LDO location
    +Motherboard size correction (width changed)
    [Shield_VCU_Board.kicad_pcb, Shield_VCU_Board.kicad_sch]
2026-02-27 Routes auto-routing
    [Shield_VCU_Board.kicad_pcb, Shield_VCU_Board.kicad_sch]
2026-02-28 Displacement corrections
    No routing done
    [Shield_VCU_Board.kicad_pcb, Shield_VCU_Board.kicad_sch]
2026-02-28 Arrangement correction
    [Shield_VCU_Board.kicad_pcb, Shield_VCU_Board.kicad_sch]
2026-03-02 Supply & NXP re-config
    [Shield_VCU_Board.kicad_pcb]
2026-03-03 LCD CPU corrections 0.1
    [Shield_VCU_Board.kicad_pcb, Shield_VCU_Board.kicad_sch]
2026-03-04 pF capacitors placement correction
    [Shield_VCU_Board.kicad_pcb, Shield_VCU_Board.kicad_sch]
2026-03-05 Displ conn pinout change
    [Shield_VCU_Board.kicad_pcb, Shield_VCU_Board.kicad_sch]
2026-03-05 NXP flip configuration
    *NXP is now flipped with J2 connector closer
    *Supply TPH2 inserted back
    *Wiring almost done
    [Shield_VCU_Board.kicad_pcb, Shield_VCU_Board.kicad_sch]
2026-03-07 Regulators and audio organisation
    [Shield_VCU_Board.kicad_pcb]
2026-03-08 Updates on board
    [Shield_VCU_Board.kicad_pcb, Shield_VCU_Board.kicad_sch]
2026-03-08 LED resistance correction
    [Shield_VCU_Board.kicad_pcb, Shield_VCU_Board.kicad_sch]
2026-03-08 Wiring_proto_Done
    Initial version of wiring - Done;
    Needs to be ckecked
    [Shield_VCU_Board.kicad_pcb]
2026-03-09 Error corrections+Footprint MP done
    [Shield_VCU_Board.kicad_pcb, Shield_VCU_Board.kicad_sch]
2026-03-09 Symbol cleanUp
    [Shield_VCU_Board.kicad_pcb, Shield_VCU_Board.kicad_sch]
2026-03-09 DSPL PINconnector fail->corrected
    Pin numbers inversed due to unknown error
    [Shield_VCU_Board.kicad_pcb, Shield_VCU_Board.kicad_sch]
2026-03-09 Layout_Label arangements
    [Shield_VCU_Board.kicad_pcb]
2026-03-09 Save_before change(Flag1)
    [Shield_VCU_Board.kicad_pcb, Shield_VCU_Board.kicad_sch]
2026-03-10 CPU_Displacement change+routing
    Bigger change coming now.
    DSPL Chip now closer to connector
    [Shield_VCU_Board.kicad_pcb, Shield_VCU_Board.kicad_sch]
2026-03-11 Routing Supply+GND
    [Shield_VCU_Board.kicad_pcb, Shield_VCU_Board.kicad_sch]
2026-03-11 PCB-ready for Check
    Component placing - Done
    Wiring - Done;
    To be checkedk
    [Shield_VCU_Board.kicad_pcb]
2026-03-12 FT-Chip flip config
    Separate GND planes not done here.
    [Shield_VCU_Board.kicad_pcb, Shield_VCU_Board.kicad_sch]
2026-03-12 GND planes added
    [Shield_VCU_Board.kicad_pcb]
2026-03-14 Clock chip rotated+wired
    [Shield_VCU_Board.kicad_pcb]
2026-03-14 IRQ signal removed
    [Shield_VCU_Board.kicad_pcb, Shield_VCU_Board.kicad_sch]
2026-03-15 Wire routing_small change
    [Shield_VCU_Board.kicad_pcb]
2026-03-15 GNDA plane added(proto)
    [Shield_VCU_Board.kicad_pcb]
2026-03-15 Audio rotate+ GNDA plane separate
    [Shield_VCU_Board.kicad_pcb]
2026-03-19 Required_corr_1.0
    *Changed wiring at Touchscreen connector
    [Shield_VCU_Board.kicad_pcb]
2026-03-19 Board size change 250x110 -> 250x107
    [Shield_VCU_Board.kicad_pcb]
2026-03-20 Required_corr_1.1
    *I2C wires
    *12V to NXP
    *LED wires removed - temporary
    *7seg Pullup res wires
    [Shield_VCU_Board.kicad_pcb, Shield_VCU_Board.kicad_sch]
2026-03-20 7seg+LED changes
    [Shield_VCU_Board.kicad_pcb, Shield_VCU_Board.kicad_sch]
2026-03-20 7seg Schematic edited
    [Shield_VCU_Board.kicad_sch]
2026-03-21 All_wires_to_0.2mm
    All the wires had the size forced to 0.2mm
    [Shield_VCU_Board.kicad_pcb, Shield_VCU_Board.kicad_sch]
2026-03-21 Wires sized
    [Shield_VCU_Board.kicad_pcb, Shield_VCU_Board.kicad_sch]
2026-03-22 LED supply wires correction
    [Shield_VCU_Board.kicad_pcb, Shield_VCU_Board.kicad_sch]
2026-03-22 GND empty spot extension
    [Shield_VCU_Board.kicad_pcb, Shield_VCU_Board.kicad_sch]
2026-03-23 GND lines added + JST connector
    [Shield_VCU_Board.kicad_pcb, Shield_VCU_Board.kicad_sch]
2026-03-24 JST connectors added
    [Shield_VCU_Board.kicad_pcb, Shield_VCU_Board.kicad_sch]
2026-03-24 JST CAN connector change
    [Shield_VCU_Board.kicad_pcb, Shield_VCU_Board.kicad_sch]
2026-03-24 CAN GND removed
    [Shield_VCU_Board.kicad_pcb, Shield_VCU_Board.kicad_sch]
2026-03-24 BJT to MOS transfer + new LED
    NMOS Datasheet: https://www.onsemi.com/pdf/datasheet/bss138-d.pdf
    LED Datasheet: https://www.mouser.com/catalog/specsheets/ams%20OSRAM_04-30-2025_LS%20ETSF.01_EN.pdf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..
    [Shield_VCU_Board.kicad_pcb, Shield_VCU_Board.kicad_sch]
2026-03-24 New Pin assignment
    [Shield_VCU_Board.kicad_pcb, Shield_VCU_Board.kicad_sch, Shield_VCU_Board.step]
2026-03-24 NMOS correction
    [Shield_VCU_Board.kicad_pcb, Shield_VCU_Board.kicad_sch]
2026-03-24 SHOTTKY x2 size change
    [Shield_VCU_Board.kicad_pcb, Shield_VCU_Board.kicad_sch]
2026-03-25 Added NXP board
    [NXP.kicad_pcb, NXP.kicad_sch, NXP344_3dSample.step, Shield_VCU_Board.step]
2026-03-25 NXP_correction for3D_Enclosure
    [NXP.kicad_pcb, Shield_VCU_Board.kicad_sch]
2026-03-26 MountingHoles:change to M3
    [Shield_VCU_Board.kicad_pcb, Shield_VCU_Board.kicad_sch]
2026-04-21 LastBOM added
    [Shield_VCU_Board.csv, Shield_VCU_Board.kicad_pcb, Shield_VCU_Board.kicad_sch]
2026-04-21 new Gerbers
    [Shield_VCU_Board-B_Cu.gbl, Shield_VCU_Board-B_Mask.gbs, Shield_VCU_Board-B_Paste.gbp, Shield_VCU_Board-B_Silkscreen.gbo, Shield_VCU_Board-Edge_Cuts.gm1, Shield_VCU_Board-F_Cu.gtl, Shield_VCU_Board-F_Mask.gts, Shield_VCU_Board-F_Paste.gtp]
2026-04-21 JST-PA -4x 1x02 - added
    [Shield_VCU_Board.csv]
2026-04-22 1x molex change in BOM
    [Shield_VCU_Board.csv, Shield_VCU_Board.kicad_pcb, Shield_VCU_Board.kicad_sch]
2026-05-08 JST partNr. correction
    10129303-116001 B --> 10129383-116001 B
    10129303-120001 B --> 10129383-120001 B
    10129303-106001 B --> 10129383-106001 B
    [Shield_VCU_Board.csv]
2026-05-26 Revision author added
    [Shield_VCU_Board.kicad_sch]
2026-06-04 Touchscreen wiring - correction
    [Shield_VCU_Board.kicad_pcb, Shield_VCU_Board.kicad_sch]
2026-06-04 Logo+ Documentation changes
    [Shield_VCU_Board.csv, Shield_VCU_Board.kicad_pcb]
2026-06-05 Display connector GND change to solid GND
    [Shield_VCU_Board.kicad_pcb]
2026-06-06 Issues txt file added
    Issues of the PCB are written here for further correction
    [Shield_VCU_Board.csv]
2026-06-08 Voltage regulator 12->7V added
    *Mounting holes replaced with simple holes
    *Resistances for power LED changed
    [Shield_VCU_Board.kicad_pcb, Shield_VCU_Board.kicad_sch]
2026-06-08 Logo correction
    [Shield_VCU_Board.kicad_pcb, Shield_VCU_Board.kicad_sch]
2026-06-09 Diode/L2/D16/etc. footprint size correction
    [Shield_VCU_Board.kicad_pcb, Shield_VCU_Board.kicad_sch]
2026-06-10 NewSupplyArchitecture - v0.1
    [NXP.kicad_pcb, NXP.kicad_sch, NXP344_3dSample.step, S32K344MINI_RevB1_BOM.xlsx, S32K344MINI_RevB1_PCBLayout.brd, S32K344MINI_RevB1_Schematic.DSN, S32K344MINI_RevC_BOM.xlsx, S32K344MINI_RevC_PCBLayout.brd]
2026-06-13 Shifting AUD 3V3 -> 5V0
    [Shield_VCU_Board.kicad_pcb, Shield_VCU_Board.kicad_sch, Shield_VCU_Boardv1.0.step, Shield_VCU_Boardv2.0.step]
2026-06-13 Major changes here
    *GND planes;
    *Supply paths
    *Chip crystal removed
    *Changes with INT/PD/SCK wiring
    [Shield_VCU_Board.kicad_pcb, Shield_VCU_Board.kicad_sch]
2026-06-14 AUDIO chip footprint corrected
    Footprint uploaded from Mouser for exact reference.
    [Shield_VCU_Board.kicad_pcb, Shield_VCU_Board.kicad_sch]
2026-06-16 GND planes correction
    [Shield_VCU_Board.kicad_pcb, Shield_VCU_Board.kicad_sch]
2026-06-17 DNP 0 Ohm resistors added
    DNP resistors added for the case where the Buck converters would have to be bridged.
    The DNP resistors are rated by their size: 1206 - 3.0A -> 4.0A that should be more than enough for this Board
    [Filter-Capacitance Multiplier.ms14, Shield_VCU_Board.kicad_pcb, Shield_VCU_Board.kicad_sch]
2026-06-20 MainGND plane corrections
    [Shield_VCU_Board.kicad_pcb, Shield_VCU_Boardv2.1.step]
2026-06-20 Changes to touchscreen i2c and display power
    [Shield_VCU_Board.kicad_pcb, Shield_VCU_Board.kicad_sch]
2026-06-20 Check on E-plan
    [Shield_VCU_Board.kicad_pcb, Shield_VCU_Board.kicad_sch]
2026-06-22 BOM v2.0 - added
    [Shield_VCU_Board.kicad_pcb, Shield_VCU_Board.kicad_sch, Shield_VCU_Boardv2.0.csv]
2026-06-24 Reworked audio area
    [Shield_VCU_Board.kicad_pcb, Shield_VCU_Board.kicad_sch]
2026-06-24 Reworked segments routing
    [Shield_VCU_Board.kicad_pcb, Shield_VCU_Board.kicad_sch]
2026-06-24 Revamped connections and ground planes for the rest of the PCB
    [Shield_VCU_Board.kicad_pcb, Shield_VCU_Board.kicad_sch]
2026-06-26 Removed GND guards
    [Shield_VCU_Board.kicad_pcb]
